gerefi/proteus/export/readme.md

4 layer PCB

135mm x 82.5mm

[changelog.md](../changelog.md)

https://github.com/gerefi/gerefi/wiki/Hardware-Proteus-Fabrication
