gerefi/proteus/readme_pinout.md

# Proteus Pinout & Wiring

### [Please use the official gerefi Proteus docs here.](https://github.com/gerefi/gerefi/wiki/Proteus-Manual)
