gerefi/proteus/export/proteus-case.step

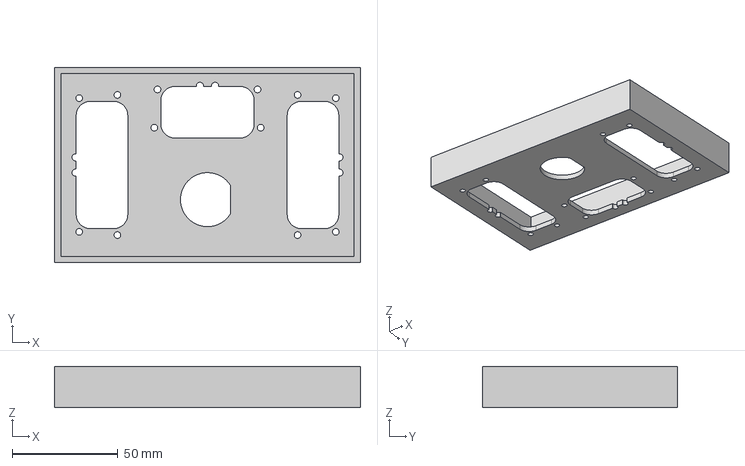
[picture p1: CAD file, 2024-03-12]
export/proteus-case.step
145.0 x 92.5 x 19.6 mm
