gerefi/proteus/(list of files, cad)

Other CAD files:
export/Proteus_case_lid_DC-45.dwg
