gerefi/proteus/Pin FMEA.xlsx

Pin type | Short -12v | Short GND | short <supply | Short 12v | short >supply | Tested?
5V sensor supply | E | C | n/a | C | C | case 1 smoke
12v sensor supply | E | C | B | A | A | case 1 reverse supplies main reg
Analog volt | B | A | A | B | B | yes
Analog temp | B | A | A | B | B | yes
Digital input | A | A | A | A | A | yes
VR input | C | C | C | C | C | yes
CANH/CANL | C | C | C | C | C | yes
Lowside output | E | C | C | C | C | case 1 smoke
Lowside output w/ diode | E | C | C | C | C | case 1 smoke
Ignition output | E | C | C | E | E | case 1 melted series R, case 4/5 overvolt 5v rail or melt R
High side output | C | C | C | C | E | case 5 smoke
Knock input | A | A | A | A | A | by design, no DC path
ETB | E | C | C | C | E | case 1 smoke, case 5 smoke
Ign supply (18) | C | n/a | B | A | A | yes
MR supply (23) | E | n/a | B | A | A | case 1 not allowed by TLE9201 DS
