gerefi/proteus/export/v0.4/proteus_0_4_schematic.pdf

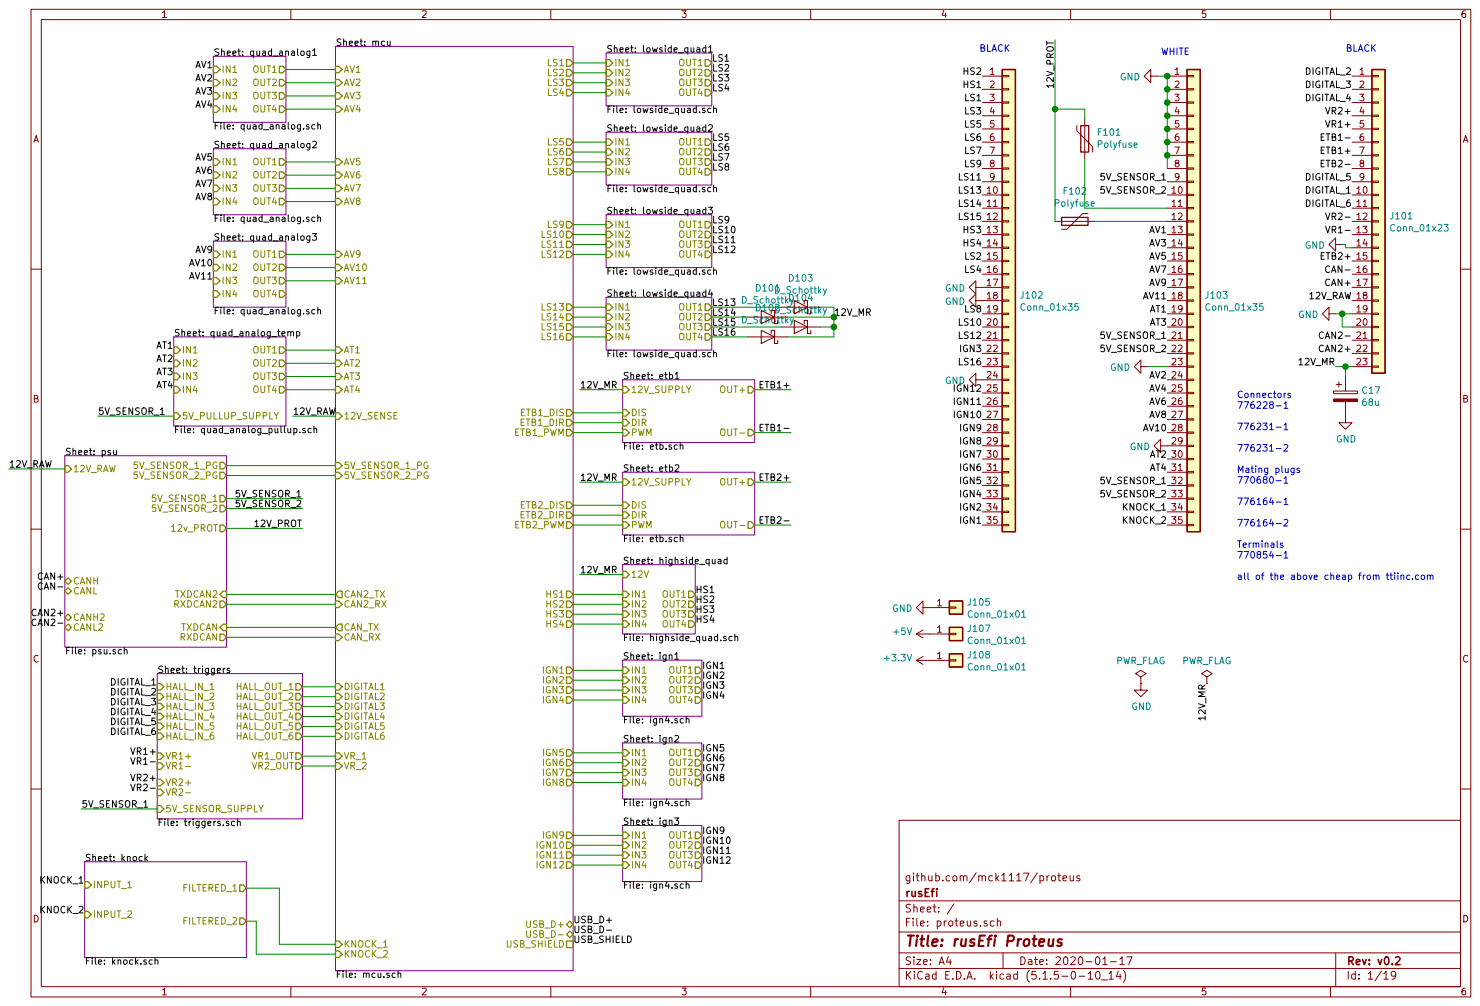
[picture p21: page 1]

Sheet: etb1 File: etb.sch

all of the above cheap from ttiinc.com

File: proteus.sch Sheet: / rusEfi github.com/mck1117/proteus

Id: 1/19 Title: rusEfi Proteus

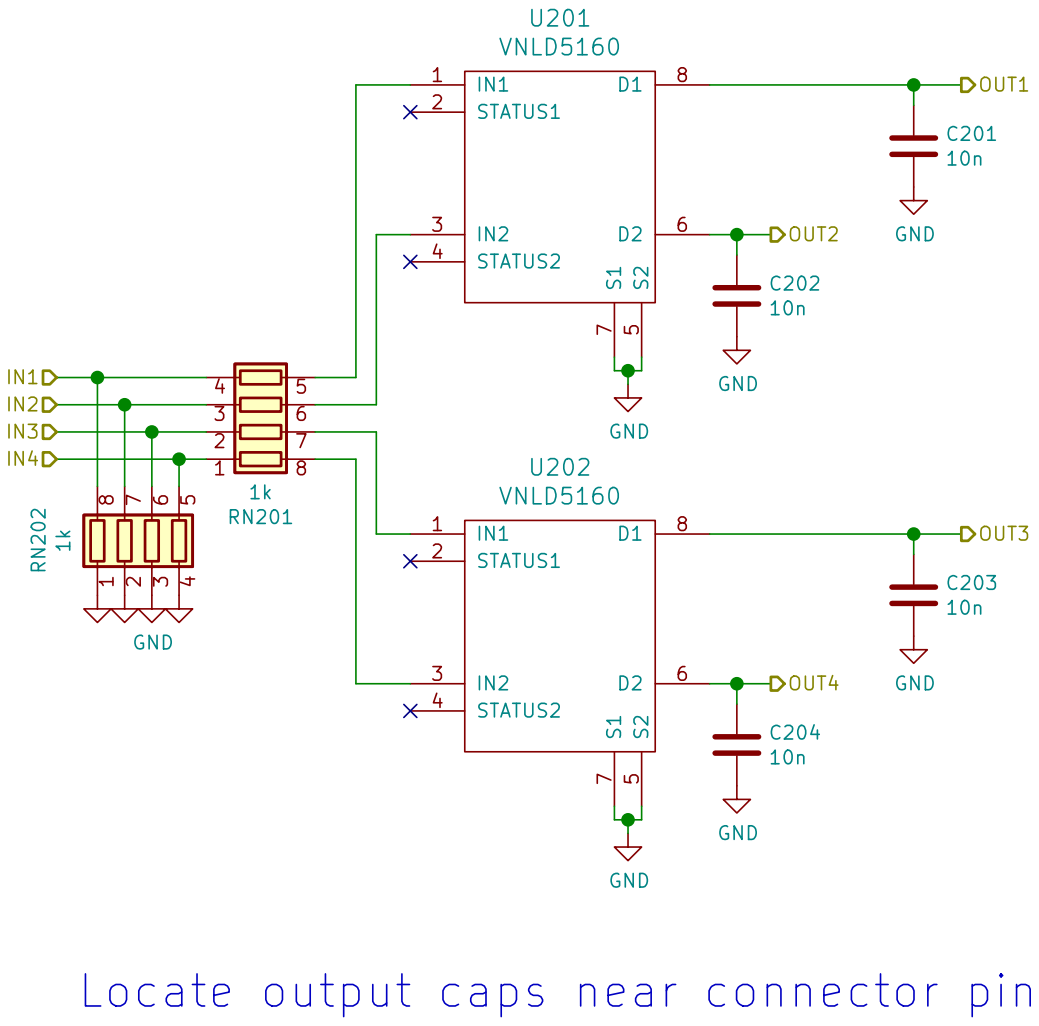
[picture p22: page 2]

7 D1 8 U201 VNLD5160GND GND GND GND GND GND GND

Sheet: /lowside_quad1/ rusEfi github.com/mck1117/proteus

File: lowside_quad.sch
Id: 2/19 Title: rusEfi Proteus

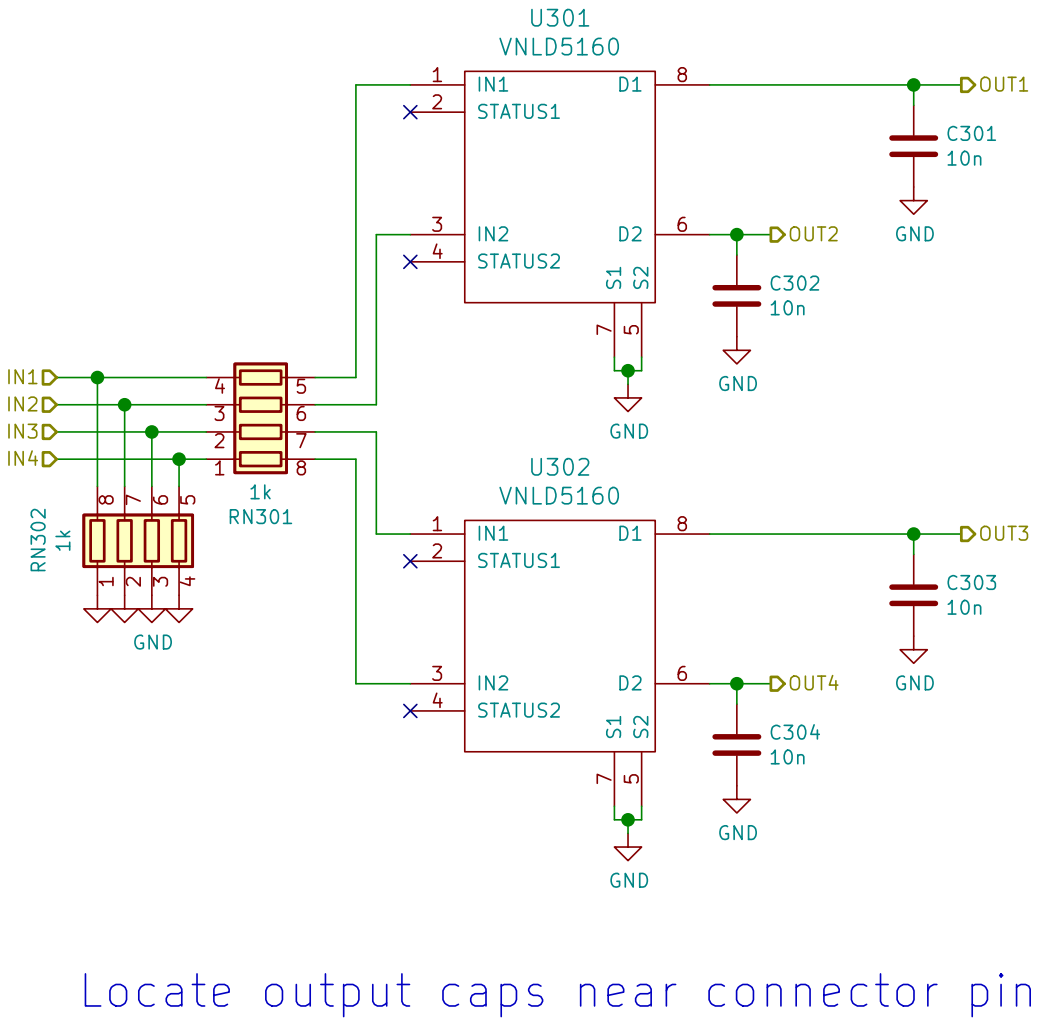
[picture p23: page 3]

7 D1 8 U301 VNLD5160GND GND GND GND GND GND GND

Sheet: /lowside_quad2/ rusEfi github.com/mck1117/proteus

File: lowside_quad.sch
Id: 3/19 Title: rusEfi Proteus

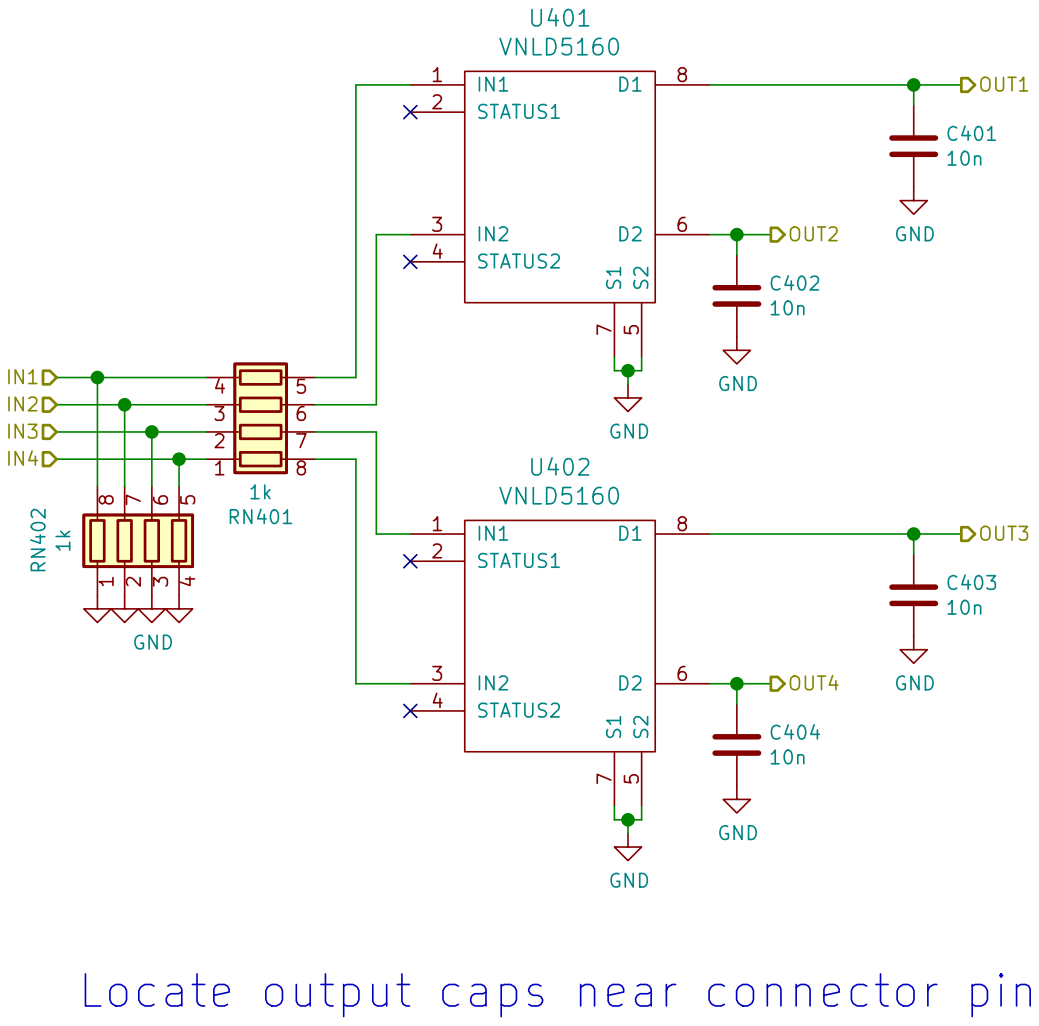
[picture p24: page 4]

7 D1 8 U401 VNLD5160GND GND GND GND GND GND GND

Sheet: /lowside_quad3/ rusEfi github.com/mck1117/proteus

File: lowside_quad.sch
Id: 4/19 Title: rusEfi Proteus

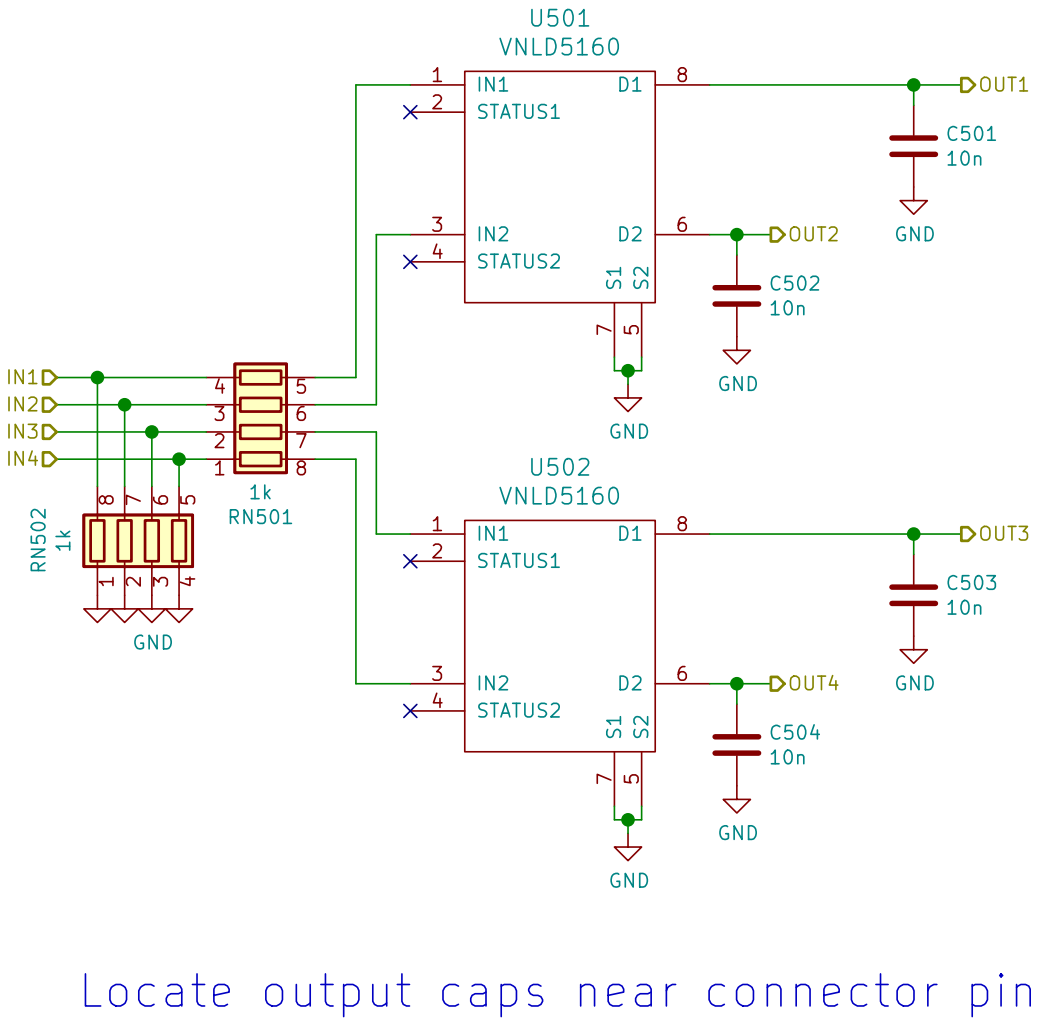
[picture p25: page 5]

7 D1 8 U501 VNLD5160GND GND GND GND GND GND GND

Sheet: /lowside_quad4/ rusEfi github.com/mck1117/proteus

File: lowside_quad.sch
Id: 5/19 Title: rusEfi Proteus

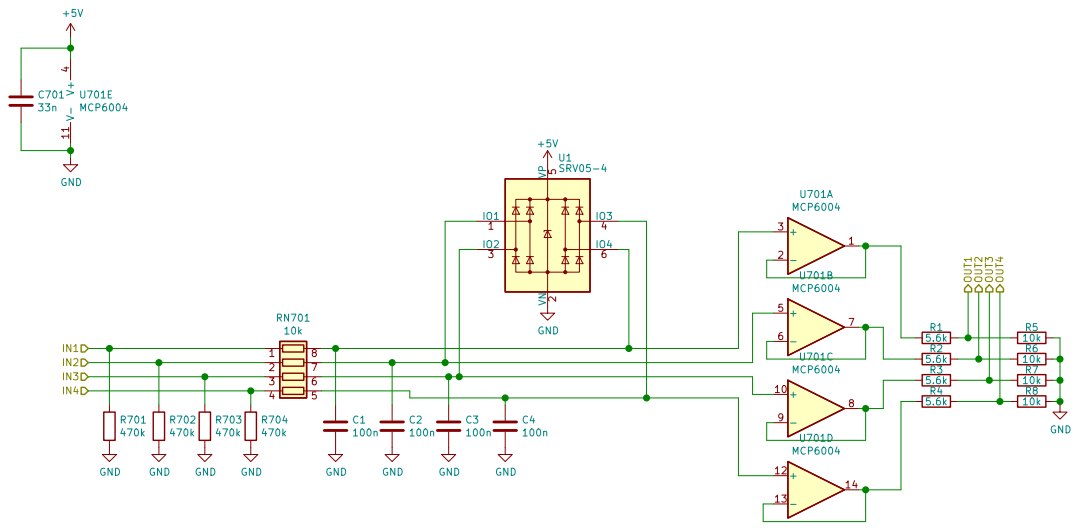
[picture p26: page 6]

Sheet: /quad_analog1/ rusEfi github.com/mck1117/proteus

File: quad_analog.sch
Id: 6/19 Title: rusEfi Proteus

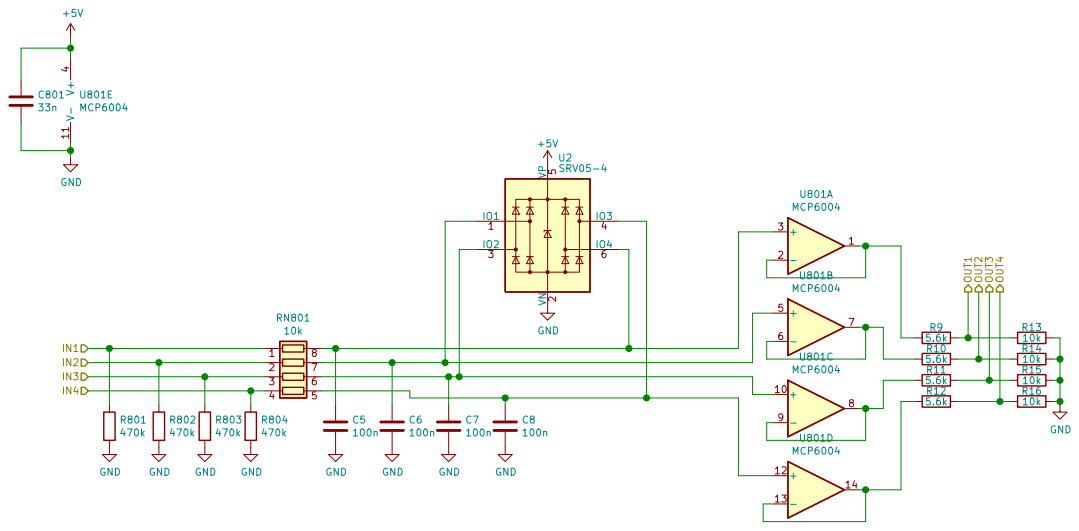
[picture p27: page 7]

Sheet: /quad_analog2/ rusEfi github.com/mck1117/proteus

File: quad_analog.sch
Id: 7/19 Title: rusEfi Proteus

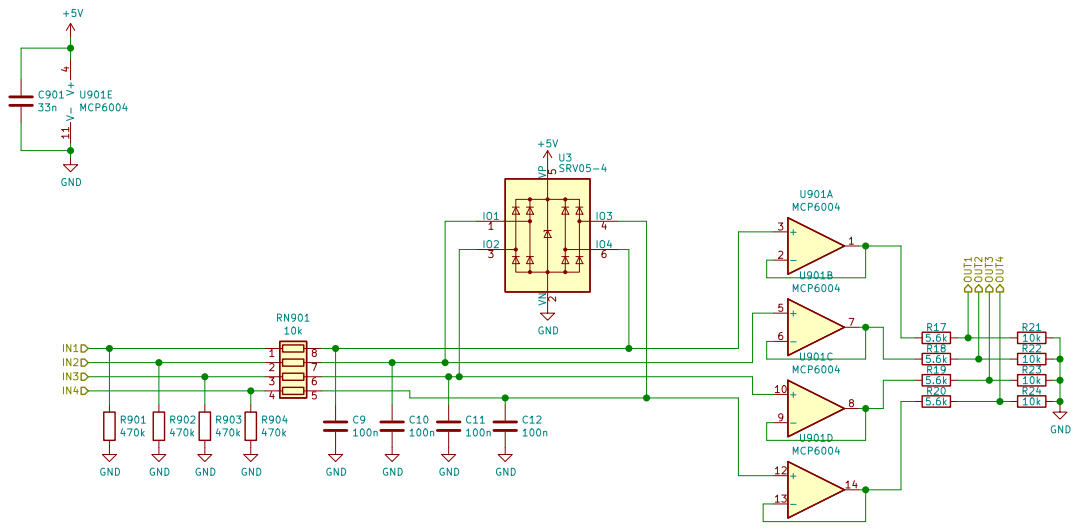
[picture p28: page 8]

Sheet: /quad_analog3/ rusEfi github.com/mck1117/proteus

File: quad_analog.sch
Id: 8/19 Title: rusEfi Proteus

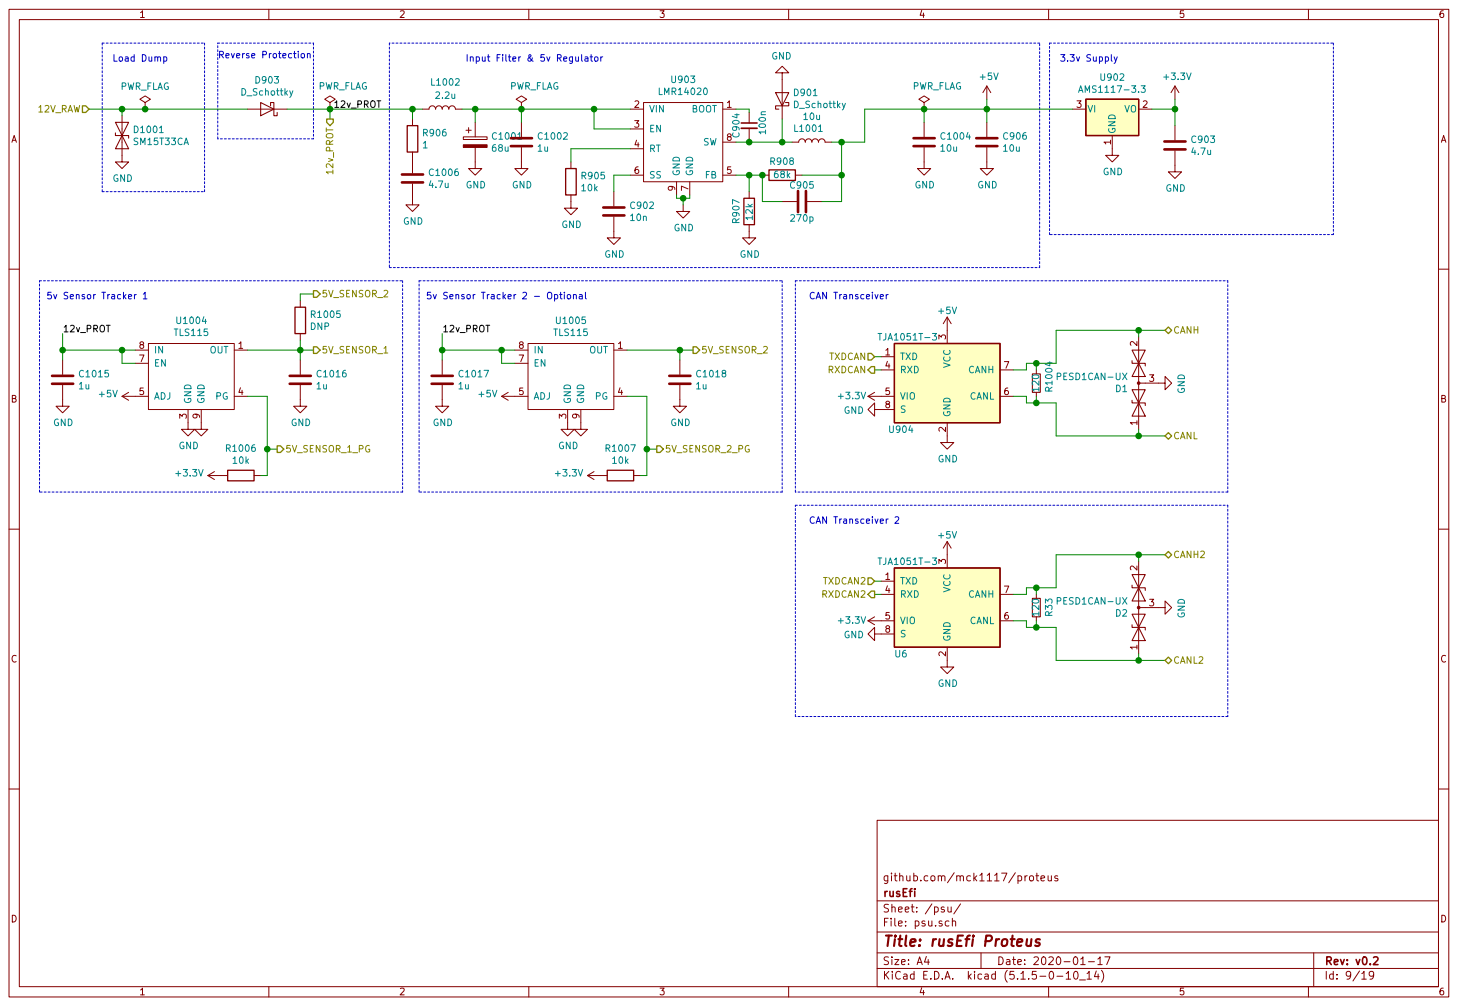
[picture p29: page 9]

1 VO 2 VI 3 U902 AMS1117-3.3 GND GND

3 RXD 4 VIO 5 CANL 6 CANH 7 S

Sheet: /psu/ rusEfi github.com/mck1117/proteus GND

File: psu.sch
Id: 9/19 Title: rusEfi Proteus

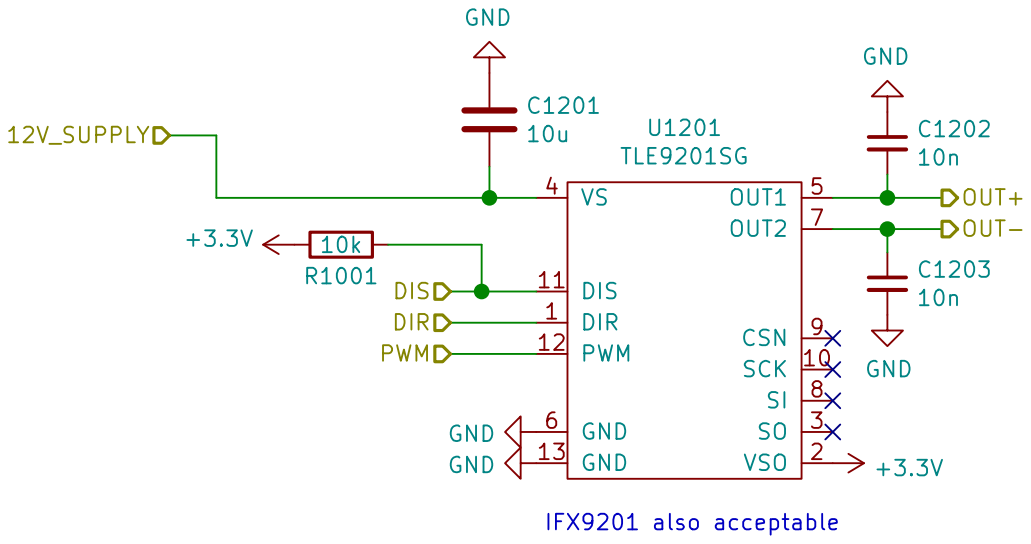
[picture p30: page 10]

File: etb.sch Sheet: /etb1/ rusEfi github.com/mck1117/proteus

Id: 10/19 Title: rusEfi Proteus

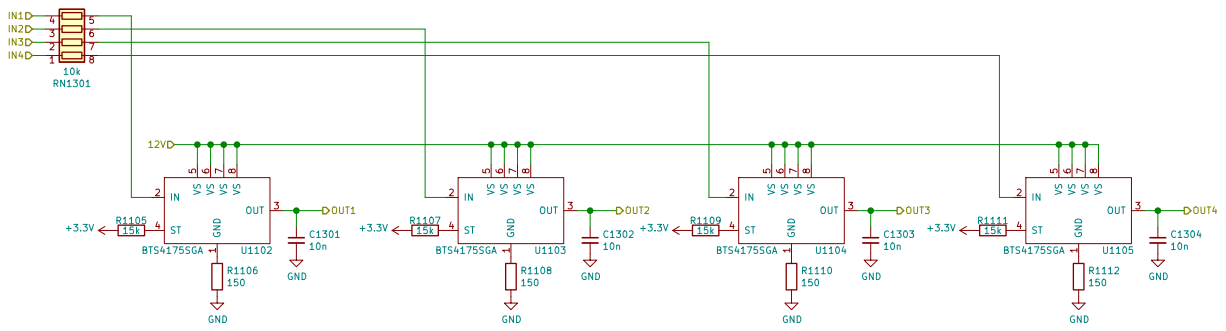
[picture p31: page 11]

Sheet: /highside_quad/ rusEfi github.com/mck1117/proteus

File: highside_quad.sch
Id: 11/19 Title: rusEfi Proteus

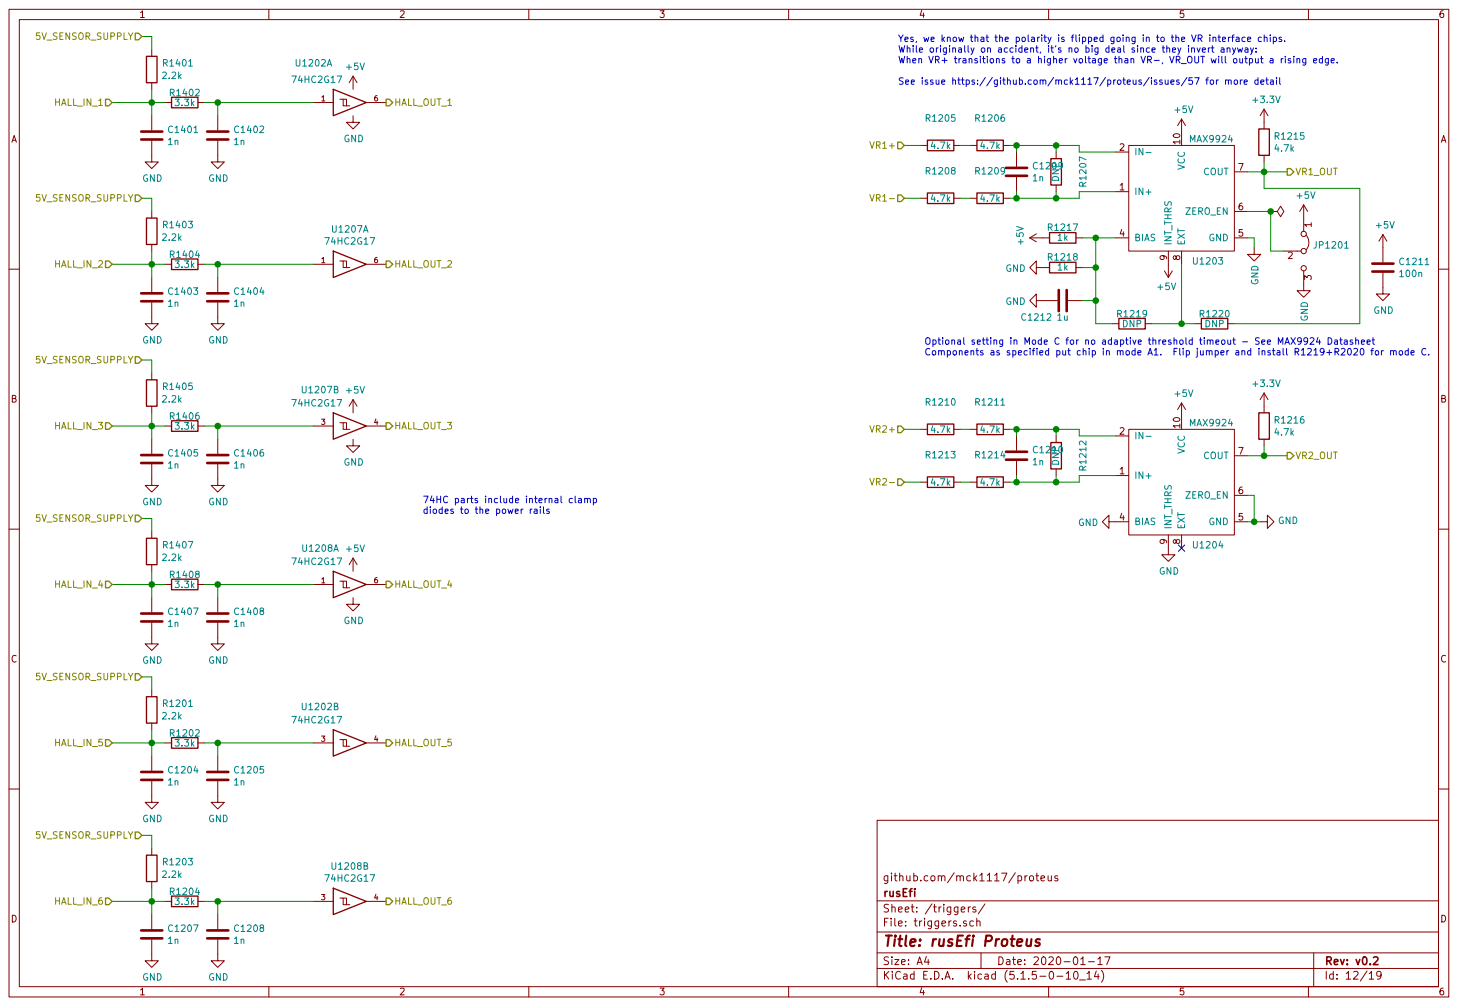
[picture p32: page 12]

Yes, we know that the polarity is flipped going in to the VR interface chips.
While originally on accident, its no big deal since they invert anyway:
When VR+ transitions to a higher voltage than VR-, VR_OUT will output a rising edge.

See issue https://github.com/mck1117/proteus/issues/57 for more detail

Optional setting in Mode C for no adaptive threshold timeout - See MAX9924 Datasheet
Components as specified put chip in mode A1. Flip jumper and install R1219+R2020 for mode C.

74HC parts include internal clamp
diodes to the power rails

Sheet: /triggers/ rusEfi github.com/mck1117/proteus

File: triggers.sch
Id: 12/19 Title: rusEfi Proteus

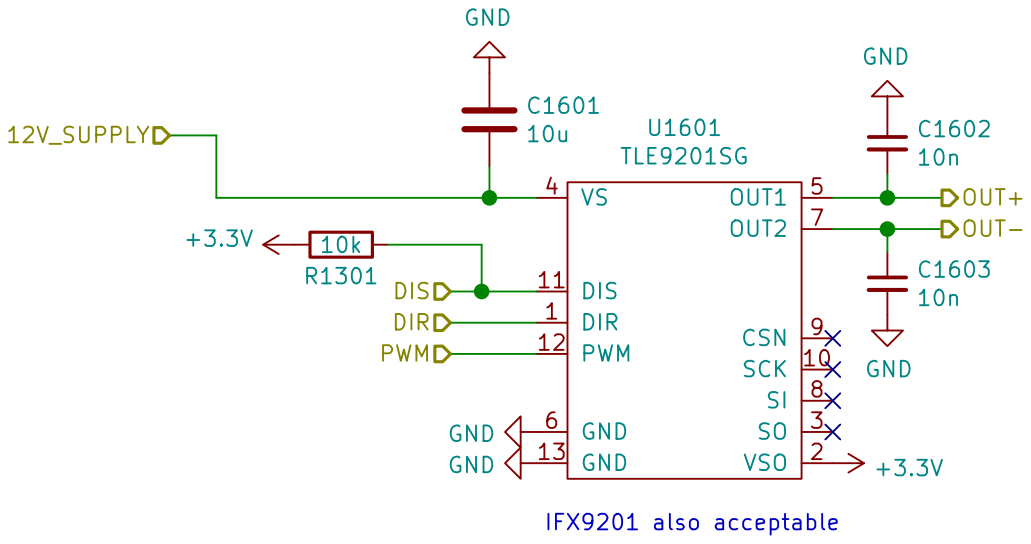
[picture p33: page 13]

File: etb.sch Sheet: /etb2/ rusEfi github.com/mck1117/proteus

Id: 13/19 Title: rusEfi Proteus

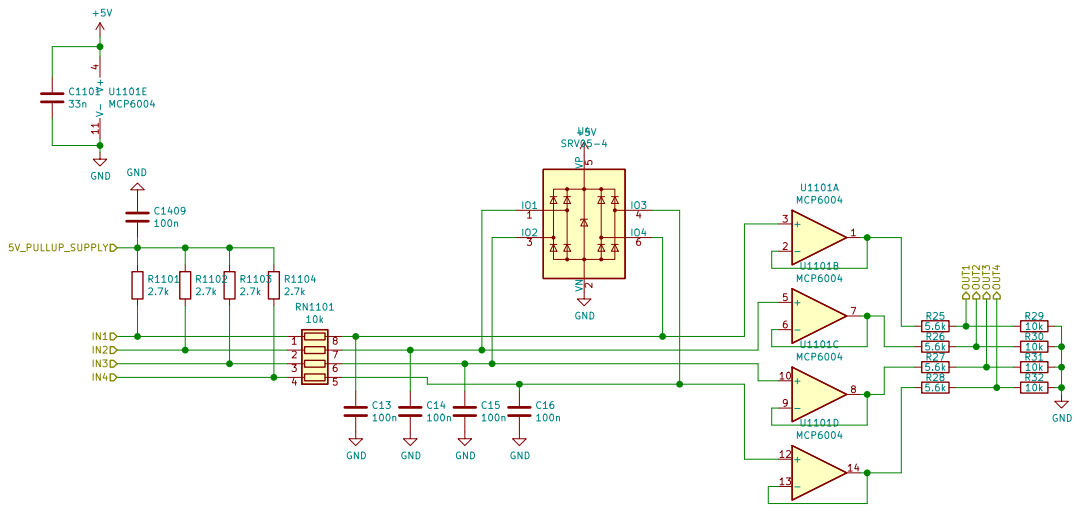
[picture p34: page 14]

Sheet: /quad_analog_temp/ rusEfi github.com/mck1117/proteus

File: quad_analog_pullup.sch
Id: 14/19 Title: rusEfi Proteus

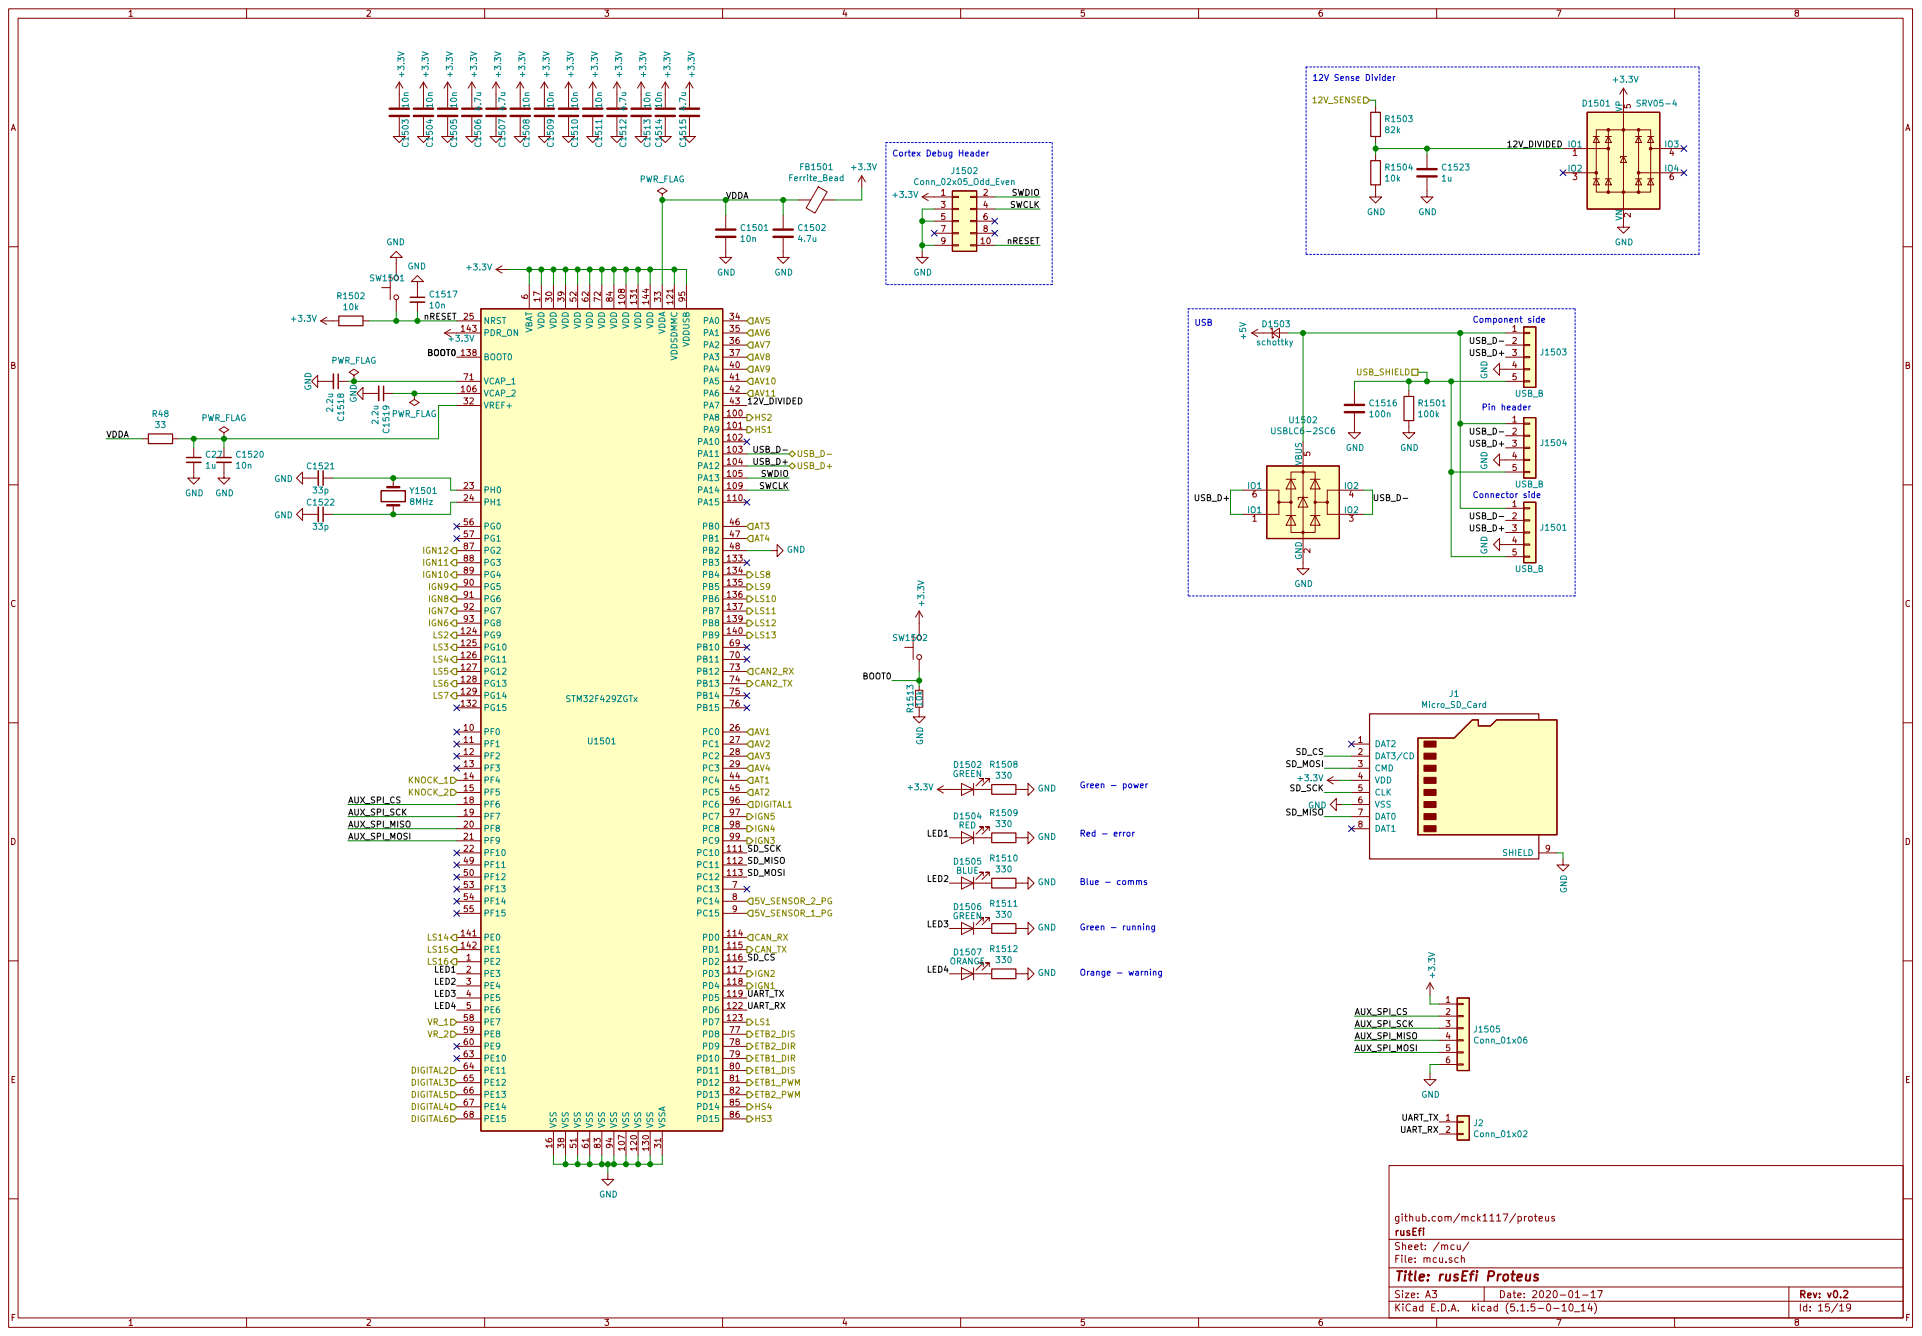
[picture p35: page 15]

Green - running Blue - comms Green - power Red - error

File: mcu.sch Sheet: /mcu/ rusEfi github.com/mck1117/proteus 12
UART_RX

Id: 15/19 Title: rusEfi Proteus

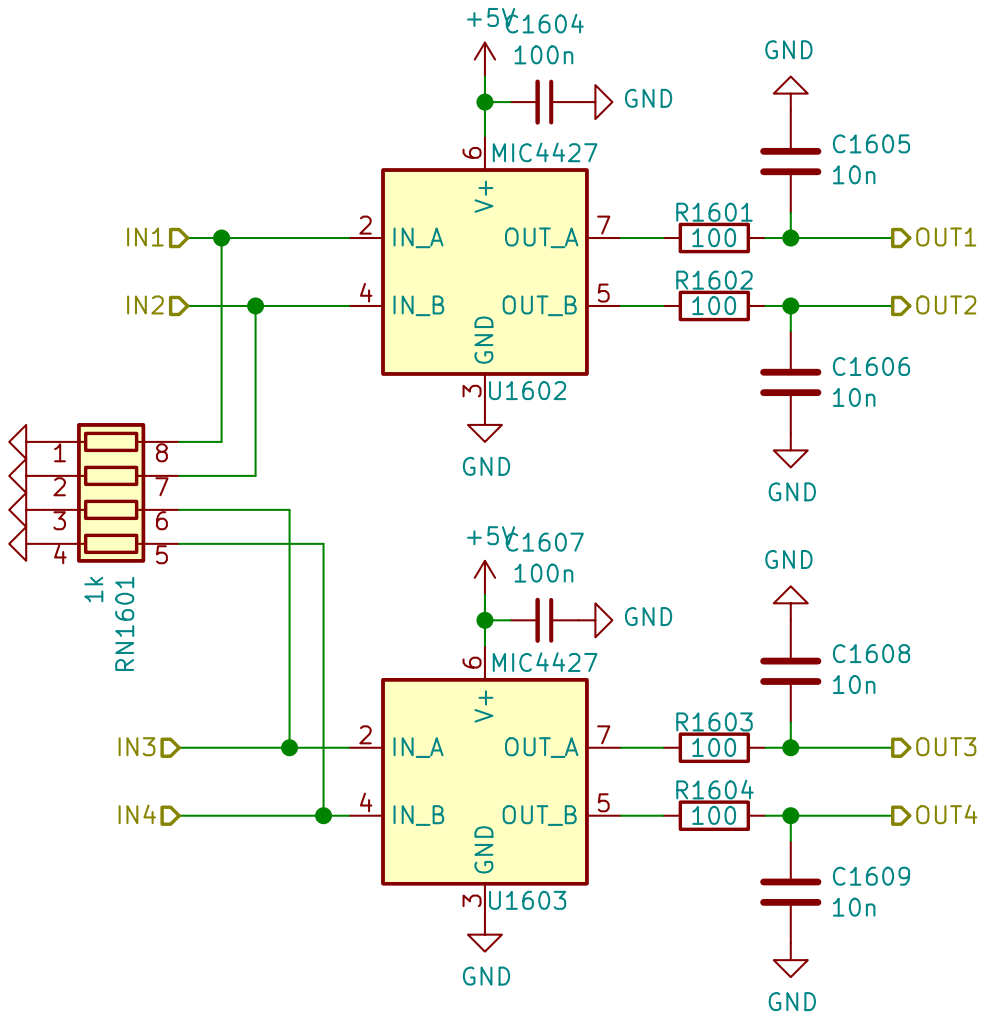
[picture p36: page 16]

Sheet: /ign1/ rusEfi github.com/mck1117/proteus

File: ign4.sch
Id: 16/19 Title: rusEfi Proteus

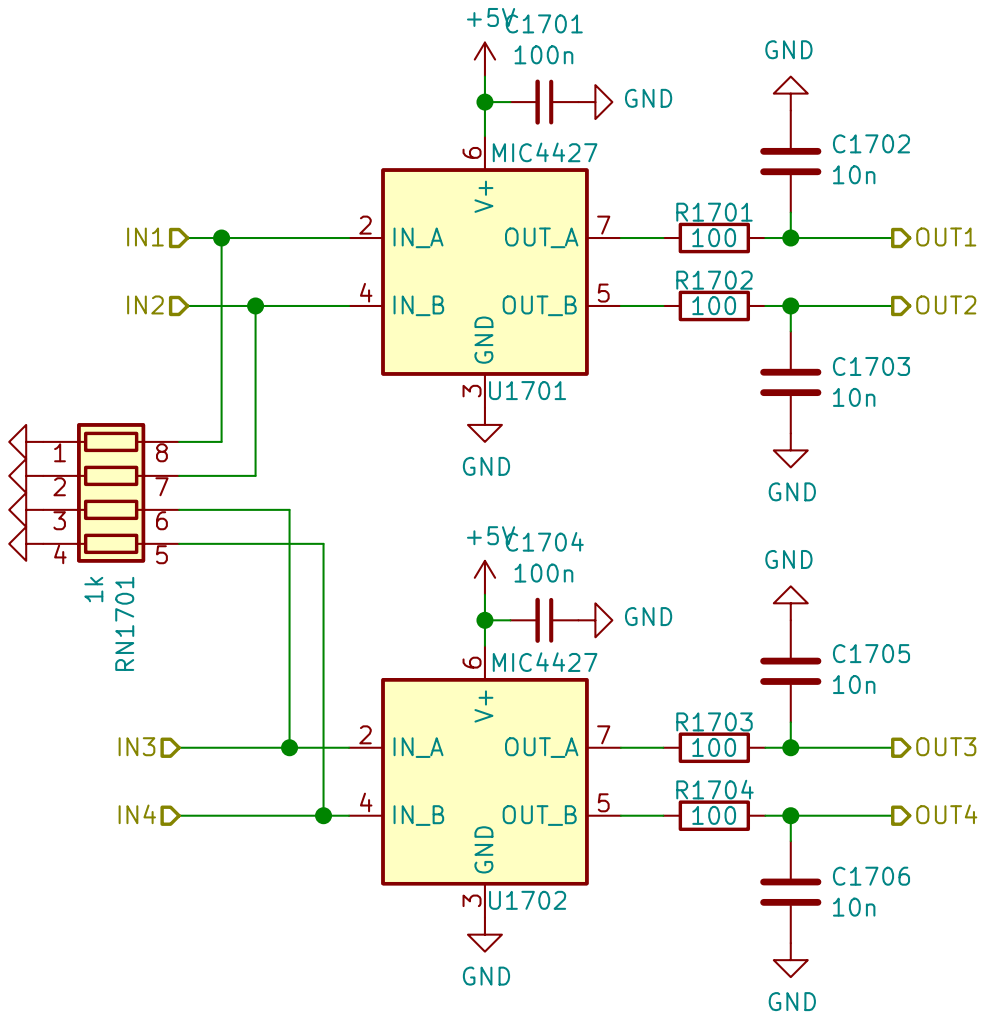
[picture p37: page 17]

Sheet: /ign2/ rusEfi github.com/mck1117/proteus

File: ign4.sch
Id: 17/19 Title: rusEfi Proteus

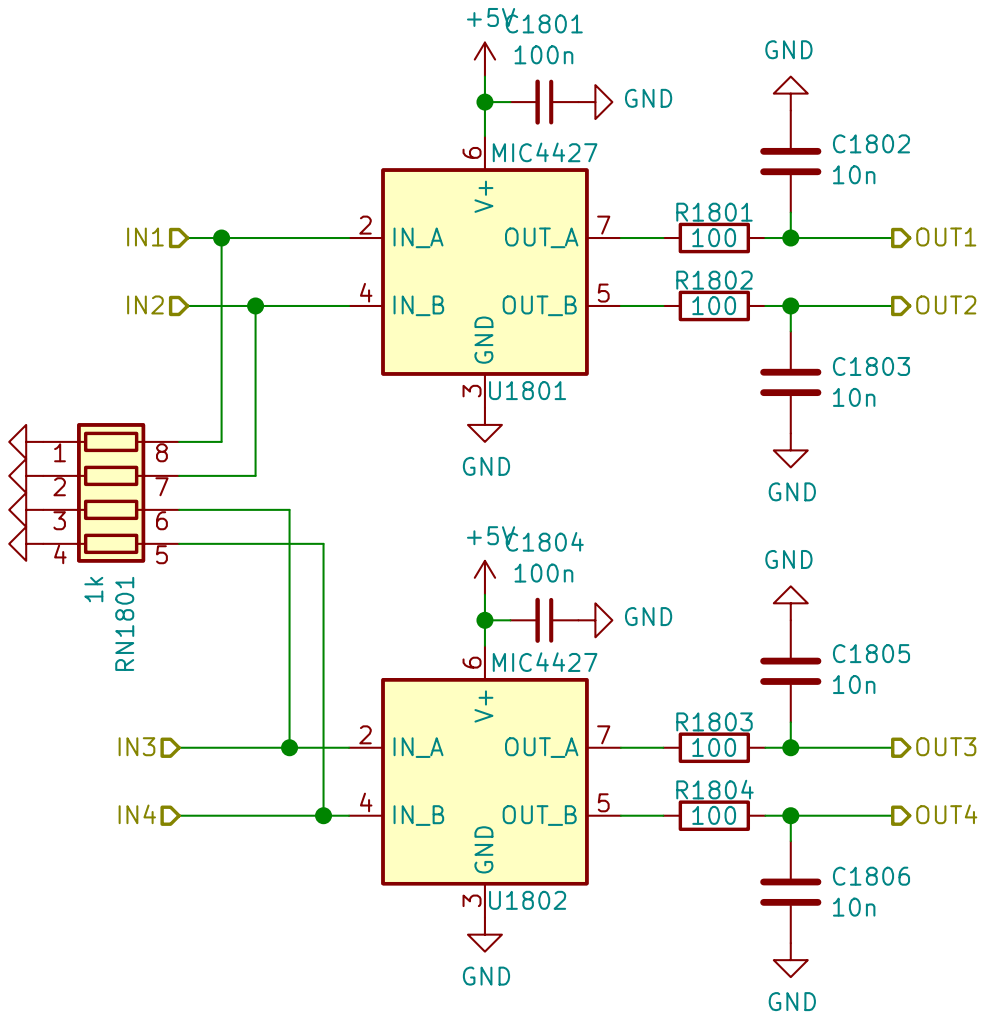
[picture p38: page 18]

Sheet: /ign3/ rusEfi github.com/mck1117/proteus

File: ign4.sch
Id: 18/19 Title: rusEfi Proteus

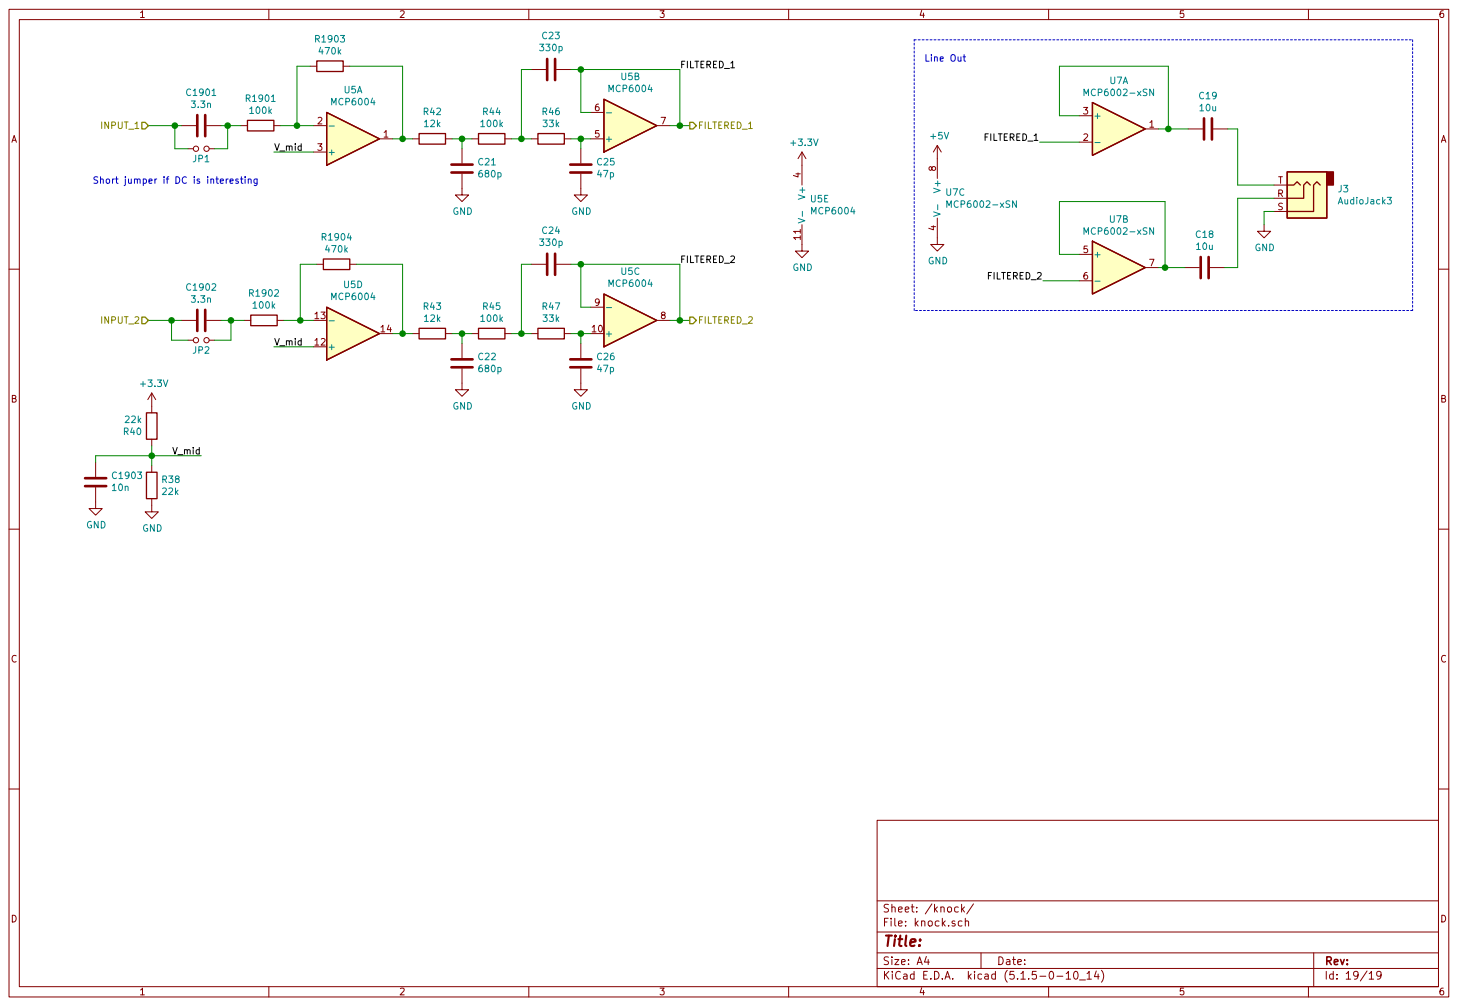
[picture p39: page 19]

Id: 19/19 Title: File: knock.sch Sheet: /knock/
