gerefi/proteus/etb-9201.sch

## KiCad design etb-9201.sch (2024-03-12)

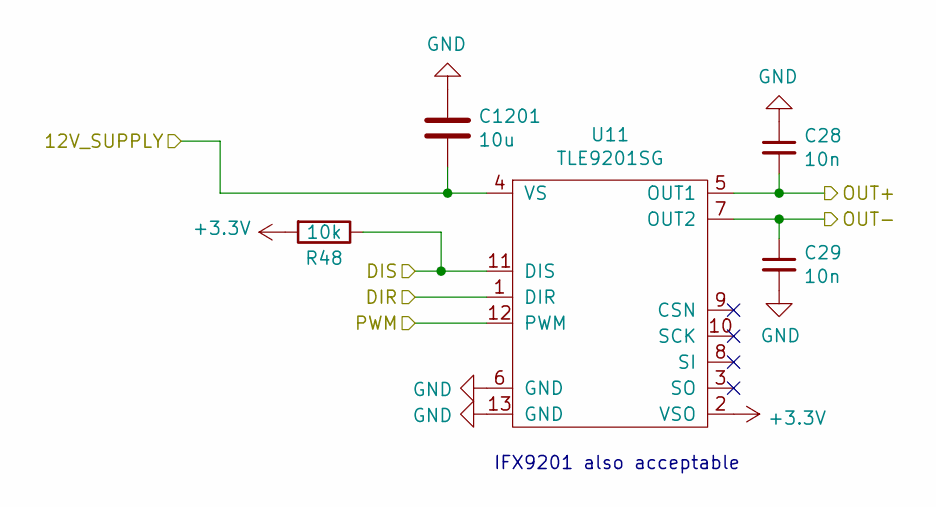
[picture p46: schematic etb-9201.sch]

Parts:
C1201: 10u; C_1206_3216Metric; LCSC C13585
C1202, C1203: 10n; C_0603_1608Metric; LCSC C57112
R1001: 10k; R_0402_1005Metric; LCSC C25744
U1201: TLE9201SG; Infineon_PG-DSO-12-9; LCSC C112633

Connections:
12V_SUPPLY: C1201.2, U1201.4 (VS)
+3.3V: R1001.2, U1201.2 (VSO)
DIR: U1201.1 (DIR)
DIS: R1001.1, U1201.11 (DIS)
GND: C1201.1, C1202.1, C1203.2, U1201.6 (GND), U1201.13 (GND)
OUT+: C1202.2, U1201.5 (OUT1)
OUT-: C1203.1, U1201.7 (OUT2)
PWM: U1201.12 (PWM)

Notes on the sheet:
IFX9201 also acceptable
