gerefi/proteus/etb.sch

## KiCad design etb.sch (2024-03-12)

Schematic: etb.sch

Parts:
C27, C1201: 10u; C_1206_3216Metric; LCSC C13585
C28, C29, C1202, C1203: 10n; C_0603_1608Metric; LCSC C57112
R48, R1001: 10k; R_0402_1005Metric; LCSC C25744
U10: TLE9202; PG-DSO-36-72; LCSC N/A
