gerefi/proteus/highside_quad.sch

## KiCad design highside_quad.sch (2024-03-12)

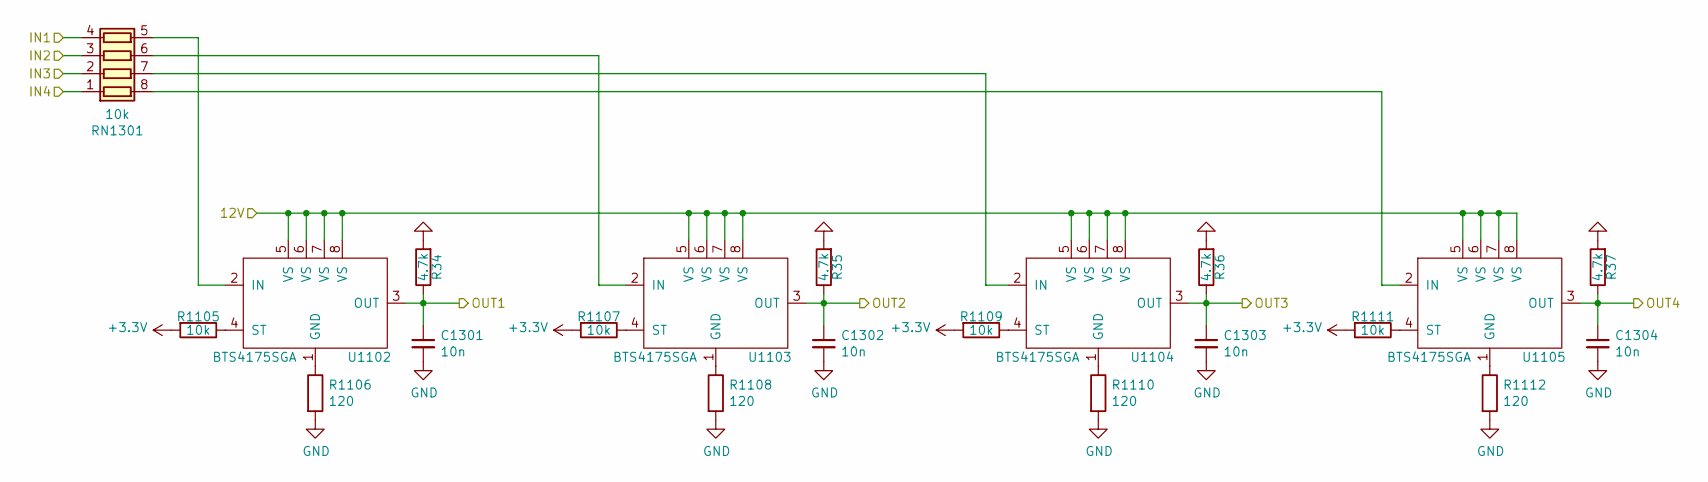
[picture p47: schematic highside_quad.sch]

Parts:
C1301, C1302, C1303, C1304: 10n; C_0603_1608Metric; LCSC C57112
R34, R35, R36, R37: 4.7k; R_0805_2012Metric; LCSC C17673
R1105, R1107, R1109, R1111: 10k; R_0402_1005Metric; LCSC C25744
R1106, R1108, R1110, R1112: 120; R_0603_1608Metric; LCSC C22787
RN1301: 10k; R_Array_Convex_4x0603; LCSC C29718
U1102, U1103, U1104, U1105: BTS4175SGA; SOIC-8_3.9x4.9mm_P1.27mm; LCSC C152451

Connections:
12V: U1102.5 (VS), U1102.6 (VS), U1102.7 (VS), U1102.8 (VS), U1103.5 (VS), U1103.6 (VS), U1103.7 (VS), U1103.8 (VS), U1104.5 (VS), U1104.6 (VS), U1104.7 (VS), U1104.8 (VS), U1105.5 (VS), U1105.6 (VS), U1105.7 (VS), U1105.8 (VS)
+3.3V: R1105.2, R1107.2, R1109.2, R1111.2
GND: C1301.2, C1302.2, C1303.2, C1304.2, R34.2, R35.2, R36.2, R37.2, R1106.2, R1108.2, R1110.2, R1112.2
IN1: RN1301.4 (R4.1)
IN2: RN1301.3 (R3.1)
IN3: RN1301.2 (R2.1)
IN4: RN1301.1 (R1.1)
unnamed: R1105.1, U1102.4 (ST)
unnamed: R1106.1, U1102.1 (GND)
unnamed: R1107.1, U1103.4 (ST)
unnamed: R1108.1, U1103.1 (GND)
unnamed: R1109.1, U1104.4 (ST)
unnamed: R1110.1, U1104.1 (GND)
unnamed: R1111.1, U1105.4 (ST)
unnamed: R1112.1, U1105.1 (GND)
unnamed: RN1301.5 (R4.2), U1102.2 (IN)
unnamed: RN1301.6 (R3.2), U1103.2 (IN)
unnamed: RN1301.7 (R2.2), U1104.2 (IN)
unnamed: RN1301.8 (R1.2), U1105.2 (IN)
OUT1: C1301.1, R34.1, U1102.3 (OUT)
OUT2: C1302.1, R35.1, U1103.3 (OUT)
OUT3: C1303.1, R36.1, U1104.3 (OUT)
OUT4: C1304.1, R37.1, U1105.3 (OUT)
