gerefi/proteus/ign4.sch

## KiCad design ign4.sch (2024-03-12)

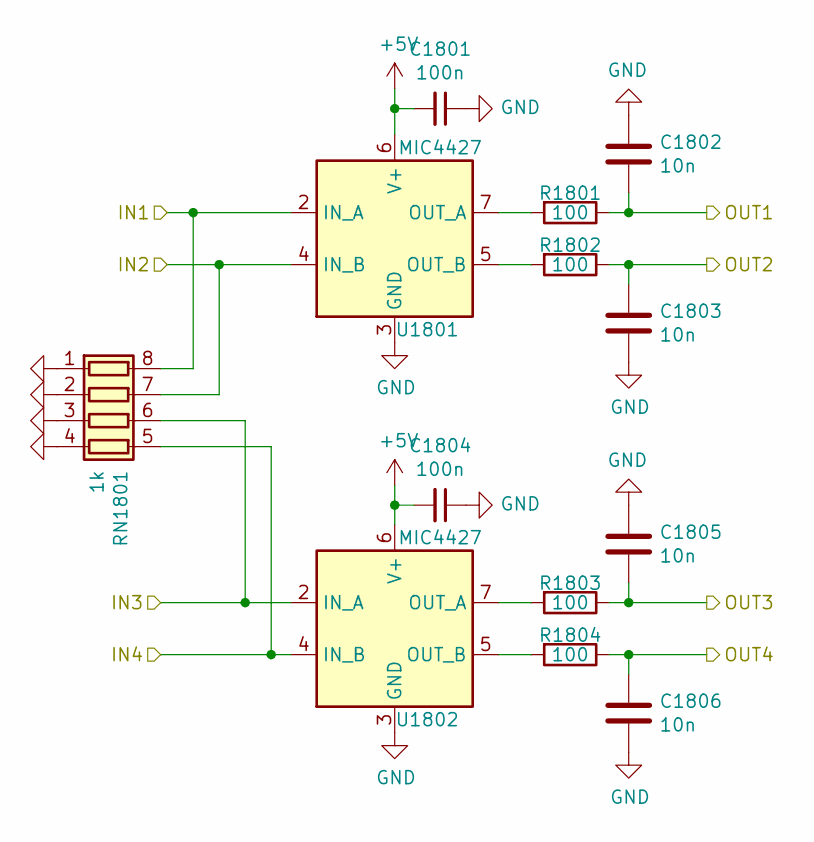
[picture p48: schematic ign4.sch]

Parts:
C1604, C1607: 100n; C_0603_1608Metric; LCSC C14663
C1605, C1606, C1608, C1609: 10n; C_0603_1608Metric; LCSC C57112
R1601, R1602, R1603, R1604: 100; R_0805_2012Metric; LCSC C17408
RN1601: 1k; R_Array_Convex_4x0603; LCSC C20197
U1602, U1603: MIC4427; SOIC-8_3.9x4.9mm_P1.27mm; LCSC C20551

Connections:
+5V: C1604.2, C1607.2, U1602.6 (V+), U1603.6 (V+)
GND: C1604.1, C1605.2, C1606.2, C1607.1, C1608.2, C1609.2, RN1601.1 (R1.1), RN1601.2 (R2.1), RN1601.3 (R3.1), RN1601.4 (R4.1), U1602.3 (GND), U1603.3 (GND)
IN1: RN1601.8 (R1.2), U1602.2 (IN_A)
IN2: RN1601.7 (R2.2), U1602.4 (IN_B)
IN3: RN1601.6 (R3.2), U1603.2 (IN_A)
IN4: RN1601.5 (R4.2), U1603.4 (IN_B)
unnamed: R1601.2, U1602.7 (OUT_A)
unnamed: R1602.2, U1602.5 (OUT_B)
unnamed: R1603.2, U1603.7 (OUT_A)
unnamed: R1604.2, U1603.5 (OUT_B)
OUT1: C1605.1, R1601.1
OUT2: C1606.1, R1602.1
OUT3: C1608.1, R1603.1
OUT4: C1609.1, R1604.1
