gerefi/proteus/knock.sch

## KiCad design knock.sch (2024-03-12)

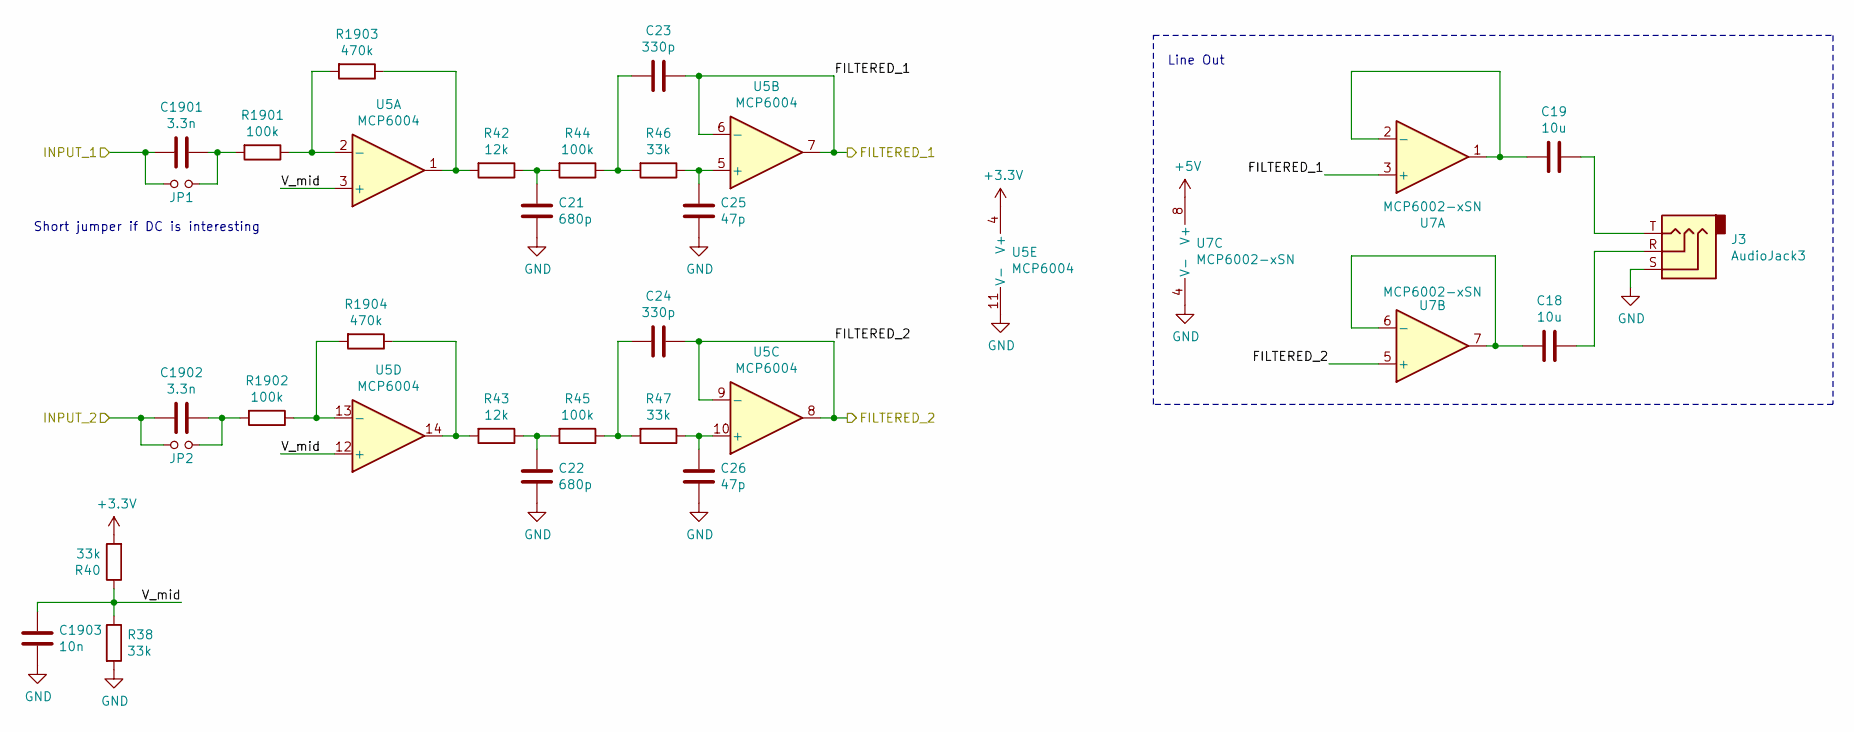
[picture p49: schematic knock.sch]

Parts:
C18, C19: 10u; C_1206_3216Metric; LCSC C13585
C21, C22: 680p; C_0603_1608Metric; LCSC C1630
C23, C24: 330p; C_0402_1005Metric; LCSC C13533
C25, C26: 47p; C_0402_1005Metric; LCSC C1567
C1901, C1902: 3.3n; C_0805_2012Metric; LCSC C53175
C1903: 10n; C_0603_1608Metric; LCSC C57112
J3: AudioJack3; Jack_3.5mm_CUI_SJ1-3533NG_Horizontal; LCSC N/A
JP1, JP2: Jumper_NO_Small; SolderJumper-2_P1.3mm_Open_TrianglePad1.0x1.5mm; LCSC N/A
R38, R40, R46, R47: 33k; R_0402_1005Metric; LCSC C25779
R42, R43: 12k; R_0402_1005Metric; LCSC C25752
R44, R45, R1901, R1902: 100k; R_0402_1005Metric; LCSC C25741
R1903, R1904: 470k; R_0402_1005Metric; LCSC C25790
U5: MCP6004; TSSOP-14_4.4x5mm_P0.65mm; LCSC C50282
U7: MCP6002-xSN; SOIC-8_3.9x4.9mm_P1.27mm; LCSC C7377

Connections:
+3.3V: R40.2, U5.4 (V+)
+5V: U7.8 (V+)
FILTERED_1: C23.2, U5.6 (-), U5.7, U7.3 (+)
FILTERED_2: C24.2, U5.8, U5.9 (-), U7.5 (+)
GND: C21.1, C22.1, C25.1, C26.1, C1903.1, J3.S, R38.2, U5.11 (V-), U7.4 (V-)
INPUT_1: C1901.2, JP1.1
INPUT_2: C1902.2, JP2.1
unnamed: C18.1, J3.R
unnamed: C18.2, U7.6 (-), U7.7
unnamed: C19.1, J3.T
unnamed: C19.2, U7.1, U7.2 (-)
unnamed: C21.2, R42.1, R44.2
unnamed: C22.2, R43.1, R45.2
unnamed: C23.1, R44.1, R46.2
unnamed: C24.1, R45.1, R47.2
unnamed: C25.2, R46.1, U5.5 (+)
unnamed: C26.2, R47.1, U5.10 (+)
unnamed: C1901.1, JP1.2, R1901.2
unnamed: C1902.1, JP2.2, R1902.2
unnamed: R1901.1, R1903.2, U5.2 (-)
unnamed: R1902.1, R1904.2, U5.13 (-)
unnamed: R42.2, R1903.1, U5.1
unnamed: R43.2, R1904.1, U5.14
V_mid: C1903.2, R38.1, R40.1, U5.3 (+), U5.12 (+)

Notes on the sheet:
Short jumper if DC is interesting
Line Out
