gerefi/proteus/lowside_quad.sch

## KiCad design lowside_quad.sch (2024-03-12)

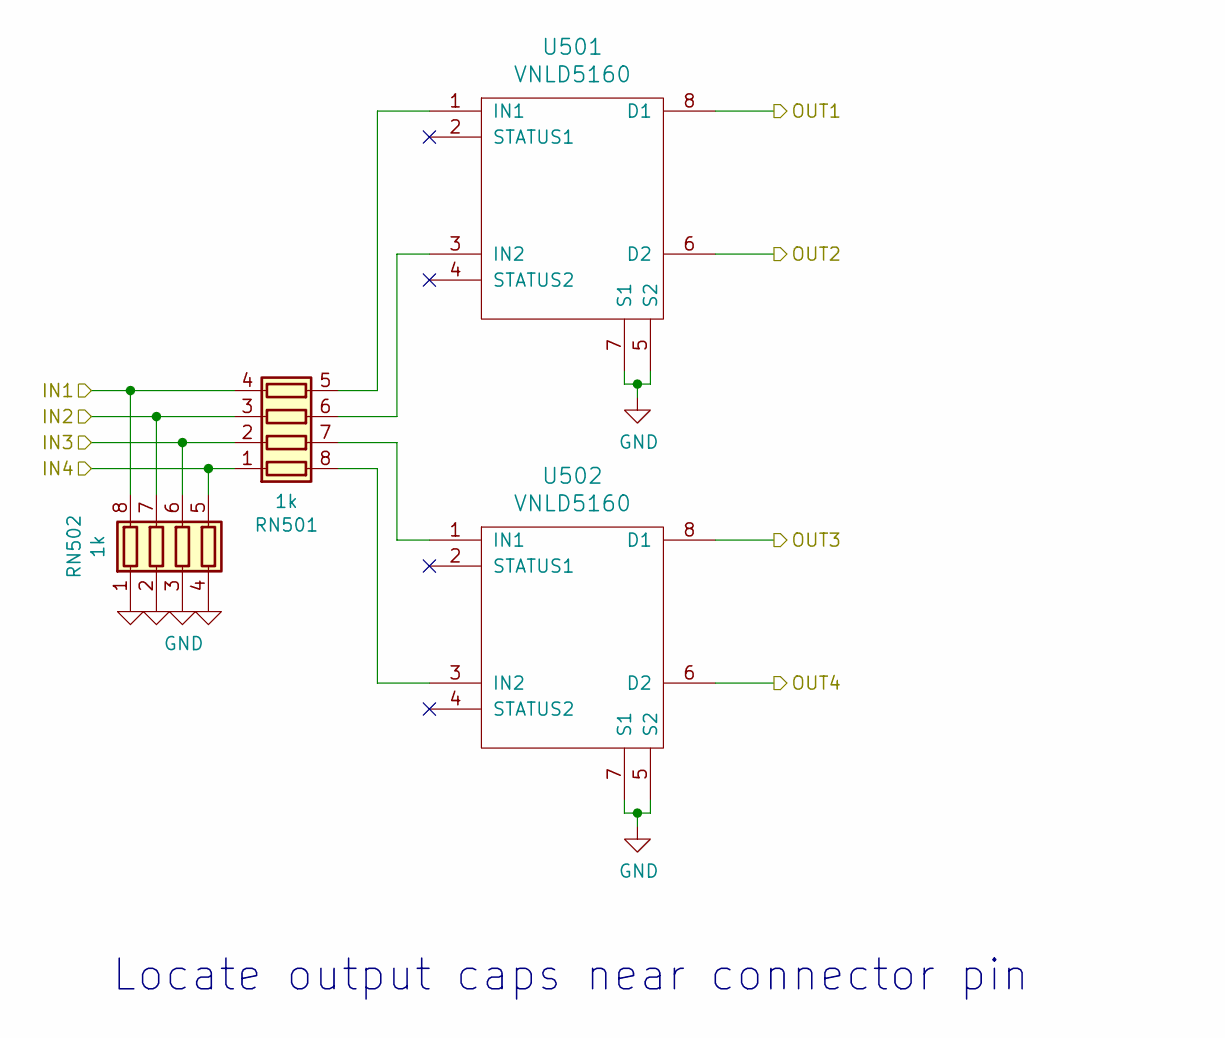
[picture p50: schematic lowside_quad.sch]

Parts:
RN201, RN202: 1k; R_Array_Convex_4x0603; LCSC C20197
U201, U202: VNLD5160; SOIC-8_3.9x4.9mm_P1.27mm; LCSC N/A

Connections:
GND: RN202.1 (R1.1), RN202.2 (R2.1), RN202.3 (R3.1), RN202.4 (R4.1), U201.5 (S2), U201.7 (S1), U202.5 (S2), U202.7 (S1)
IN1: RN201.4 (R4.1), RN202.8 (R1.2)
IN2: RN201.3 (R3.1), RN202.7 (R2.2)
IN3: RN201.2 (R2.1), RN202.6 (R3.2)
IN4: RN201.1 (R1.1), RN202.5 (R4.2)
unnamed: RN201.5 (R4.2), U201.1 (IN1)
unnamed: RN201.6 (R3.2), U201.3 (IN2)
unnamed: RN201.7 (R2.2), U202.1 (IN1)
unnamed: RN201.8 (R1.2), U202.3 (IN2)
OUT1: U201.8 (D1)
OUT2: U201.6 (D2)
OUT3: U202.8 (D1)
OUT4: U202.6 (D2)

Notes on the sheet:
Locate output caps near connector pin
