gerefi/proteus/proteus.sch

## KiCad design proteus.sch (2024-03-12)

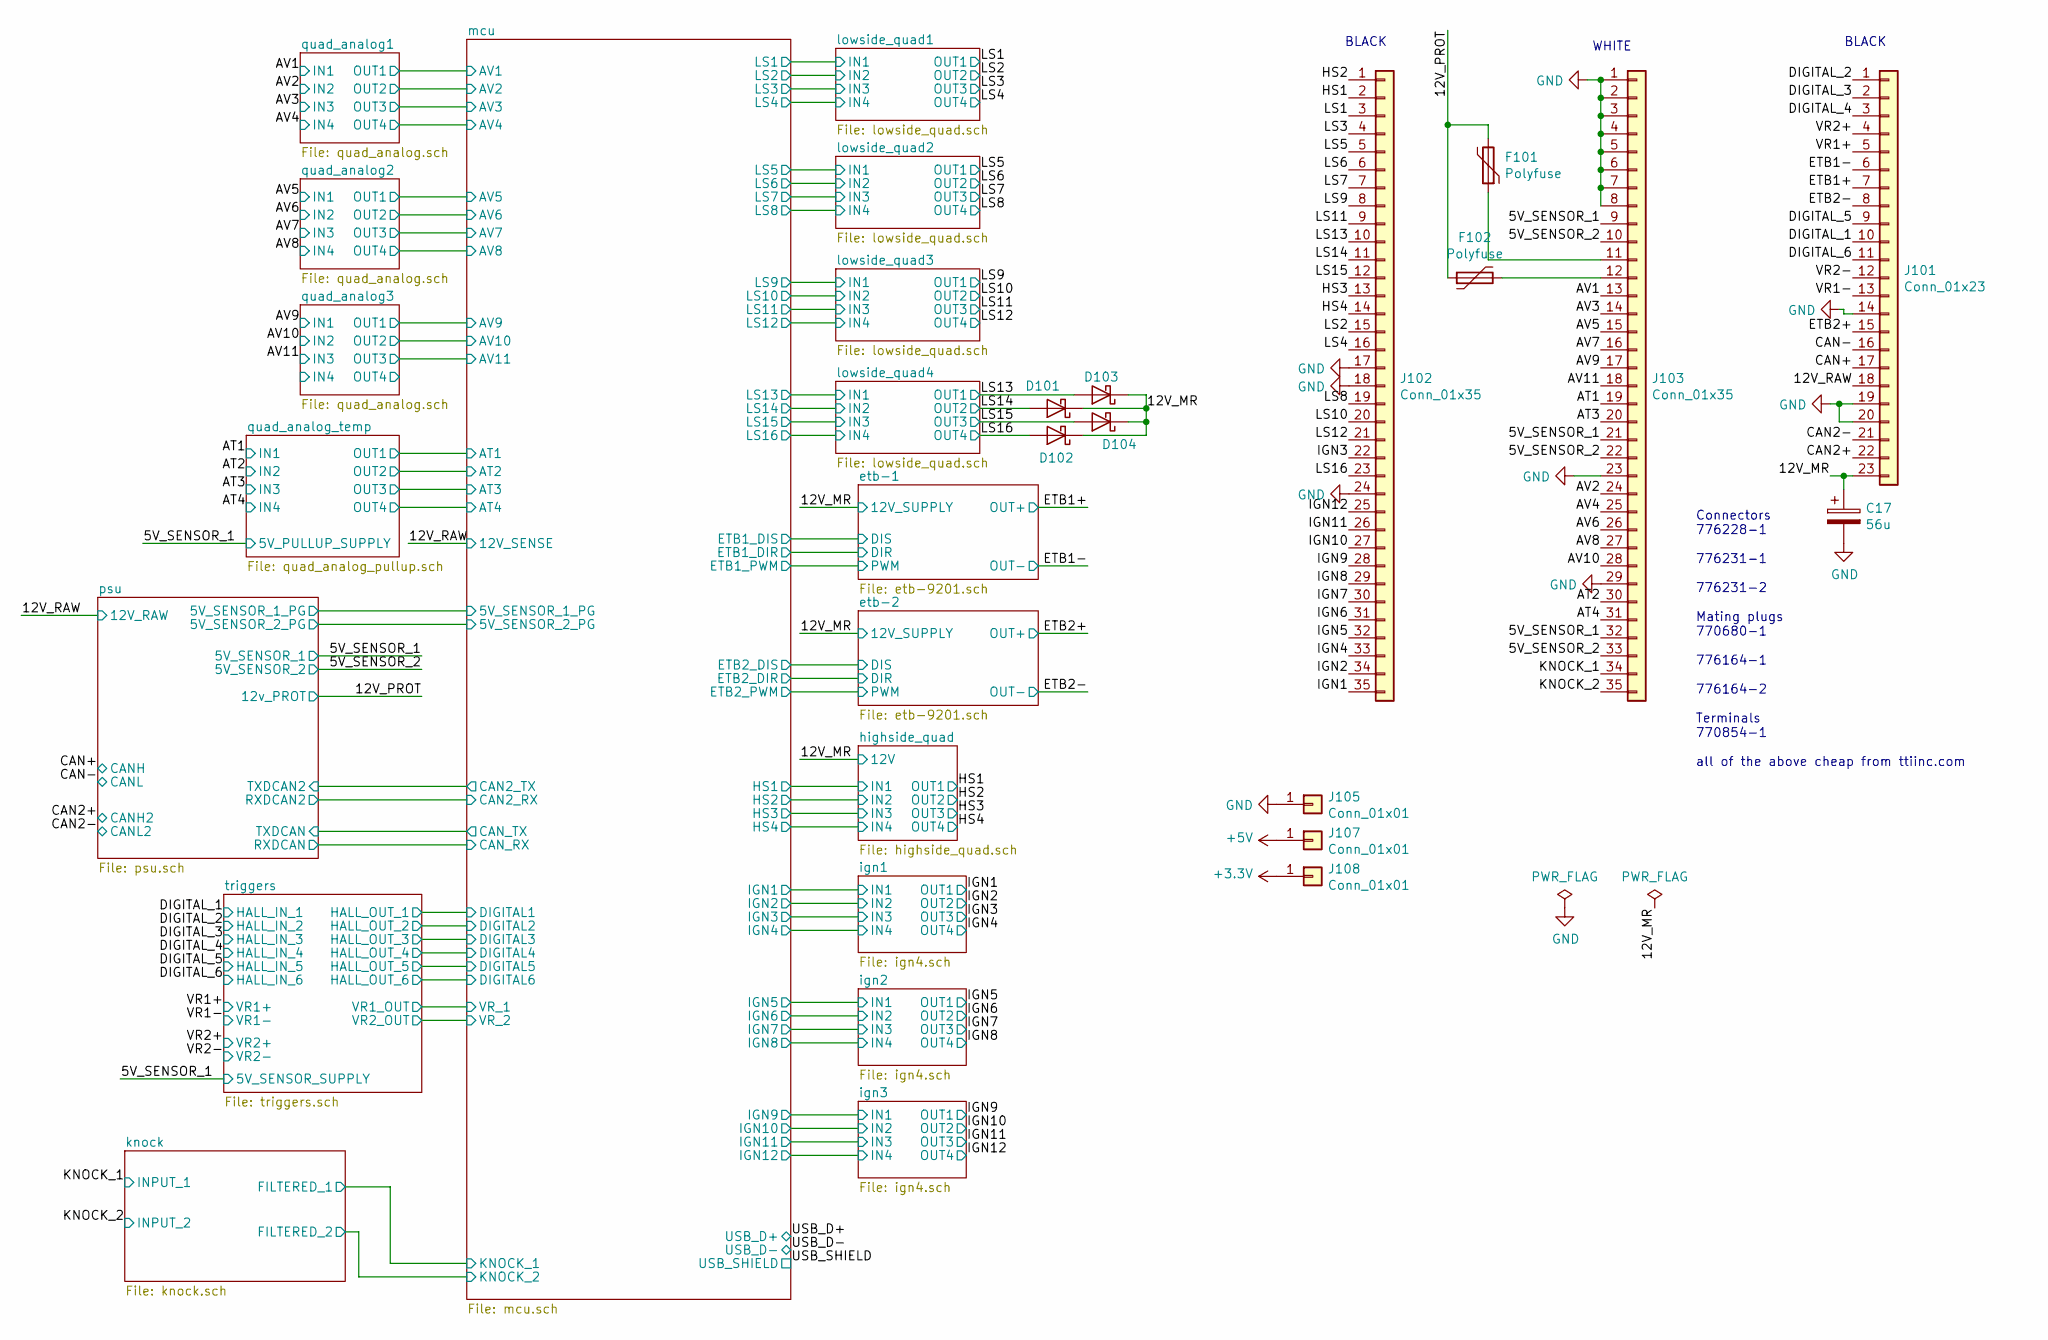
[picture p52: schematic proteus.sch]

Parts:
C17: 56u; CP_Radial_D8.0mm_P3.50mm; LCSC N/A
D101, D102, D103, D104: D_Schottky; D_SMA; LCSC C8678
F101, F102: Polyfuse; R_1206_3216Metric; LCSC C207035
J101: Conn_01x23; ampseal-23; LCSC N/A
J102: Conn_01x35; ampseal-35; LCSC N/A
J103: Conn_01x35; ampseal-35-2; LCSC N/A
J105, J107, J108: Conn_01x01; TestPoint_Pad_D3.0mm; LCSC N/A

Connections:
5V_SENSOR_1: J103.9, J103.21, J103.32
5V_SENSOR_2: J103.10, J103.22, J103.33
12V_MR: C17.1, D101.1 (K), D102.1 (K), D103.1 (K), D104.1 (K), J101.23
12V_PROT: F101.2, F102.1
12V_RAW: J101.18
+3.3V: J108.1
+5V: J107.1
AT1: J103.19
AT2: J103.30
AT3: J103.20
AT4: J103.31
AV1: J103.13
AV2: J103.24
AV3: J103.14
AV4: J103.25
AV5: J103.15
AV6: J103.26
AV7: J103.16
AV8: J103.27
AV9: J103.17
AV10: J103.28
AV11: J103.18
CAN2+: J101.22
CAN2-: J101.21
CAN+: J101.17
CAN-: J101.16
DIGITAL_1: J101.10
DIGITAL_2: J101.1
DIGITAL_3: J101.2
DIGITAL_4: J101.3
DIGITAL_5: J101.9
DIGITAL_6: J101.11
ETB1+: J101.7
ETB1-: J101.6
ETB2+: J101.15
ETB2-: J101.8
GND: C17.2, J101.14, J101.19, J101.20, J102.17, J102.18, J102.24, J103.1, J103.2, J103.3, J103.4, J103.5, J103.6, J103.7, J103.8, J103.23, J103.29, J105.1
HS1: J102.2
HS2: J102.1
HS3: J102.13
HS4: J102.14
IGN1: J102.35
IGN2: J102.34
IGN3: J102.22
IGN4: J102.33
IGN5: J102.32
IGN6: J102.31
IGN7: J102.30
IGN8: J102.29
IGN9: J102.28
IGN10: J102.27
IGN11: J102.26
IGN12: J102.25
KNOCK_1: J103.34
KNOCK_2: J103.35
LS1: J102.3
LS2: J102.15
LS3: J102.4
LS4: J102.16
LS5: J102.5
LS6: J102.6
LS7: J102.7
LS8: J102.19
LS9: J102.8
LS10: J102.20
LS11: J102.9
LS12: J102.21
LS13: D103.2 (A), J102.10
LS14: D101.2 (A), J102.11
LS15: D104.2 (A), J102.12
LS16: D102.2 (A), J102.23
unnamed: F101.1, J103.11
unnamed: F102.2, J103.12
VR1+: J101.5
VR1-: J101.13
VR2+: J101.4
VR2-: J101.12

Notes on the sheet:
Connectors 776228-1 776231-1 776231-2 Mating plugs 770680-1 776164-1 776164-2 Terminals 770854-1 all of the above cheap from ttiinc.com
BLACK
WHITE
