gerefi/proteus/quad_analog.sch

## KiCad design quad_analog.sch (2024-03-12)

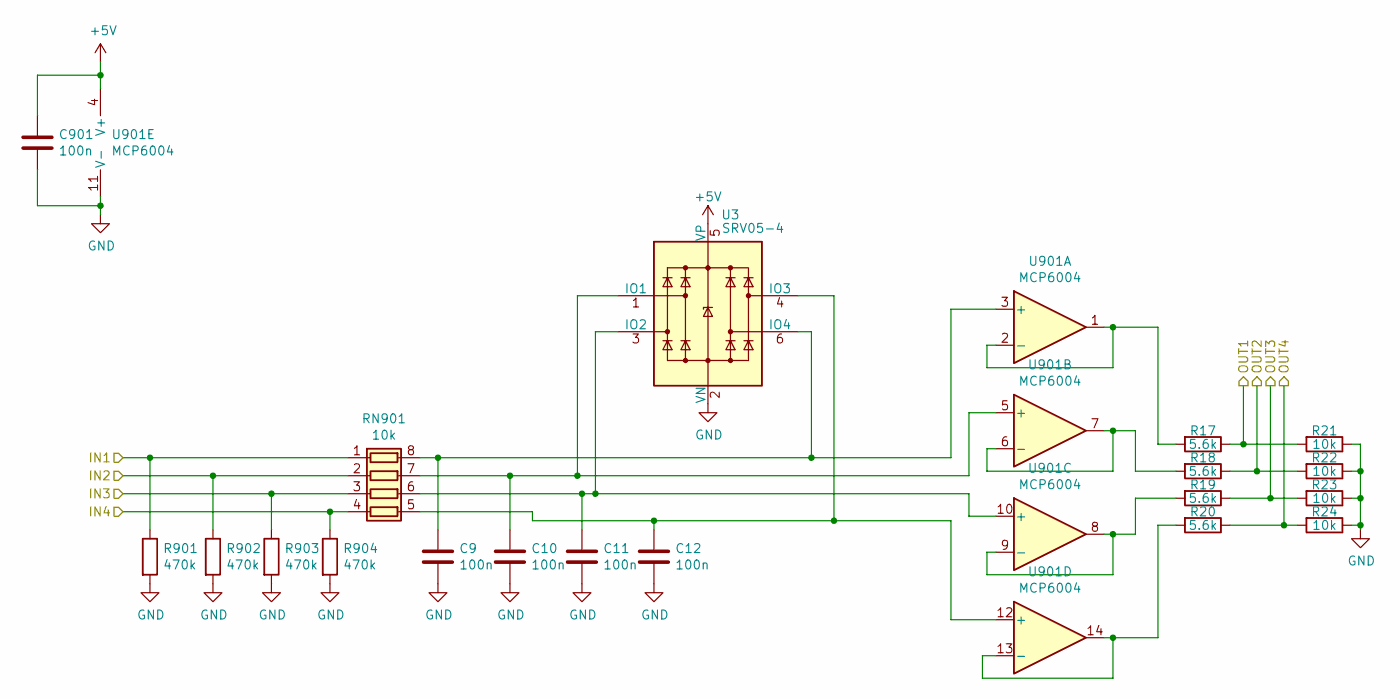
[picture p54: schematic quad_analog.sch]

Parts:
C1, C2, C3, C4: 100n; C_0402_1005Metric; LCSC C1525
C701: 100n; C_0603_1608Metric; LCSC C14663
R1, R2, R3, R4: 5.6k; R_0402_1005Metric; LCSC C25908
R5, R6, R7, R8: 10k; R_0402_1005Metric; LCSC C25744
R701, R702, R703, R704: 470k; R_0402_1005Metric; LCSC C25790
RN701: 10k; R_Array_Convex_4x0603; LCSC C29718
U1: SRV05-4; SOT-23-6; LCSC C85364
U701: MCP6004; TSSOP-14_4.4x5mm_P0.65mm; LCSC C50282

Connections:
+5V: C701.1, U1.5 (VP), U701.4 (V+)
GND: C1.2, C2.2, C3.2, C4.2, C701.2, R5.1, R6.1, R7.1, R8.1, R701.2, R702.2, R703.2, R704.2, U1.2 (VN), U701.11 (V-)
IN1: R701.1, RN701.1 (R1.1)
IN2: R702.1, RN701.2 (R2.1)
IN3: R703.1, RN701.3 (R3.1)
IN4: R704.1, RN701.4 (R4.1)
unnamed: C1.1, RN701.8 (R1.2), U1.6 (IO4), U701.3 (+)
unnamed: C2.1, RN701.7 (R2.2), U1.1 (IO1), U701.5 (+)
unnamed: C3.1, RN701.6 (R3.2), U1.3 (IO2), U701.10 (+)
unnamed: C4.1, RN701.5 (R4.2), U1.4 (IO3), U701.12 (+)
unnamed: R1.2, U701.1, U701.2 (-)
unnamed: R2.2, U701.6 (-), U701.7
unnamed: R3.2, U701.8, U701.9 (-)
unnamed: R4.2, U701.13 (-), U701.14
OUT1: R1.1, R5.2
OUT2: R2.1, R6.2
OUT3: R3.1, R7.2
OUT4: R4.1, R8.2
