gerefi/proteus/quad_analog_pullup.sch

## KiCad design quad_analog_pullup.sch (2024-03-12)

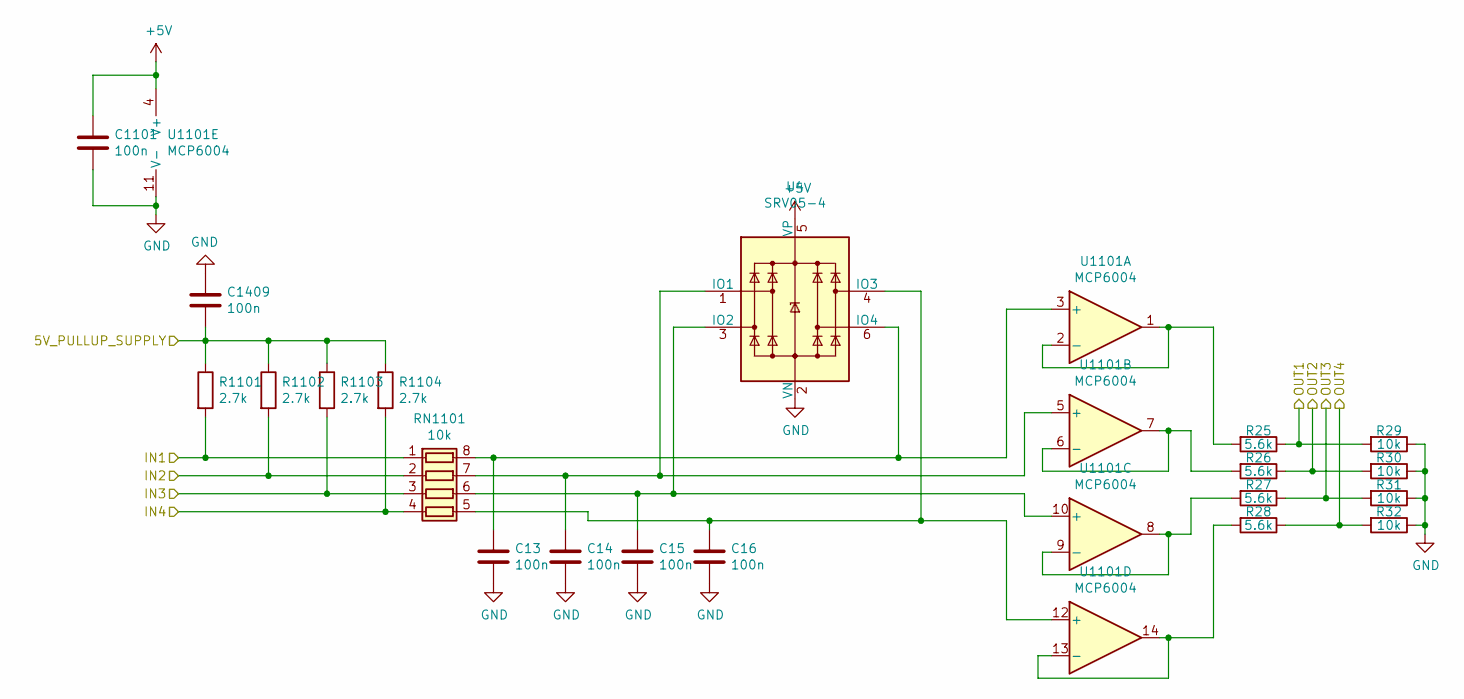
[picture p55: schematic quad_analog_pullup.sch]

Parts:
C13, C14, C15, C16: 100n; C_0402_1005Metric; LCSC C1525
C1101, C1409: 100n; C_0603_1608Metric; LCSC C14663
R25, R26, R27, R28: 5.6k; R_0402_1005Metric; LCSC C25908
R29, R30, R31, R32: 10k; R_0402_1005Metric; LCSC C25744
R1101, R1102, R1103, R1104: 2.7k; R_0603_1608Metric; LCSC C13167
RN1101: 10k; R_Array_Convex_4x0603; LCSC C29718
U4: SRV05-4; SOT-23-6; LCSC C85364
U1101: MCP6004; TSSOP-14_4.4x5mm_P0.65mm; LCSC C50282

Connections:
5V_PULLUP_SUPPLY: C1409.2, R1101.1, R1102.1, R1103.1, R1104.1
+5V: C1101.1, U4.5 (VP), U1101.4 (V+)
GND: C13.2, C14.2, C15.2, C16.2, C1101.2, C1409.1, R29.1, R30.1, R31.1, R32.1, U4.2 (VN), U1101.11 (V-)
IN1: R1101.2, RN1101.1 (R1.1)
IN2: R1102.2, RN1101.2 (R2.1)
IN3: R1103.2, RN1101.3 (R3.1)
IN4: R1104.2, RN1101.4 (R4.1)
unnamed: C13.1, RN1101.8 (R1.2), U4.6 (IO4), U1101.3 (+)
unnamed: C14.1, RN1101.7 (R2.2), U4.1 (IO1), U1101.5 (+)
unnamed: C15.1, RN1101.6 (R3.2), U4.3 (IO2), U1101.10 (+)
unnamed: C16.1, RN1101.5 (R4.2), U4.4 (IO3), U1101.12 (+)
unnamed: R25.2, U1101.1, U1101.2 (-)
unnamed: R26.2, U1101.6 (-), U1101.7
unnamed: R27.2, U1101.8, U1101.9 (-)
unnamed: R28.2, U1101.13 (-), U1101.14
OUT1: R25.1, R29.2
OUT2: R26.1, R30.2
OUT3: R27.1, R31.2
OUT4: R28.1, R32.2
