gerefi/proteus/triggers.sch

## KiCad design triggers.sch (2024-03-12)

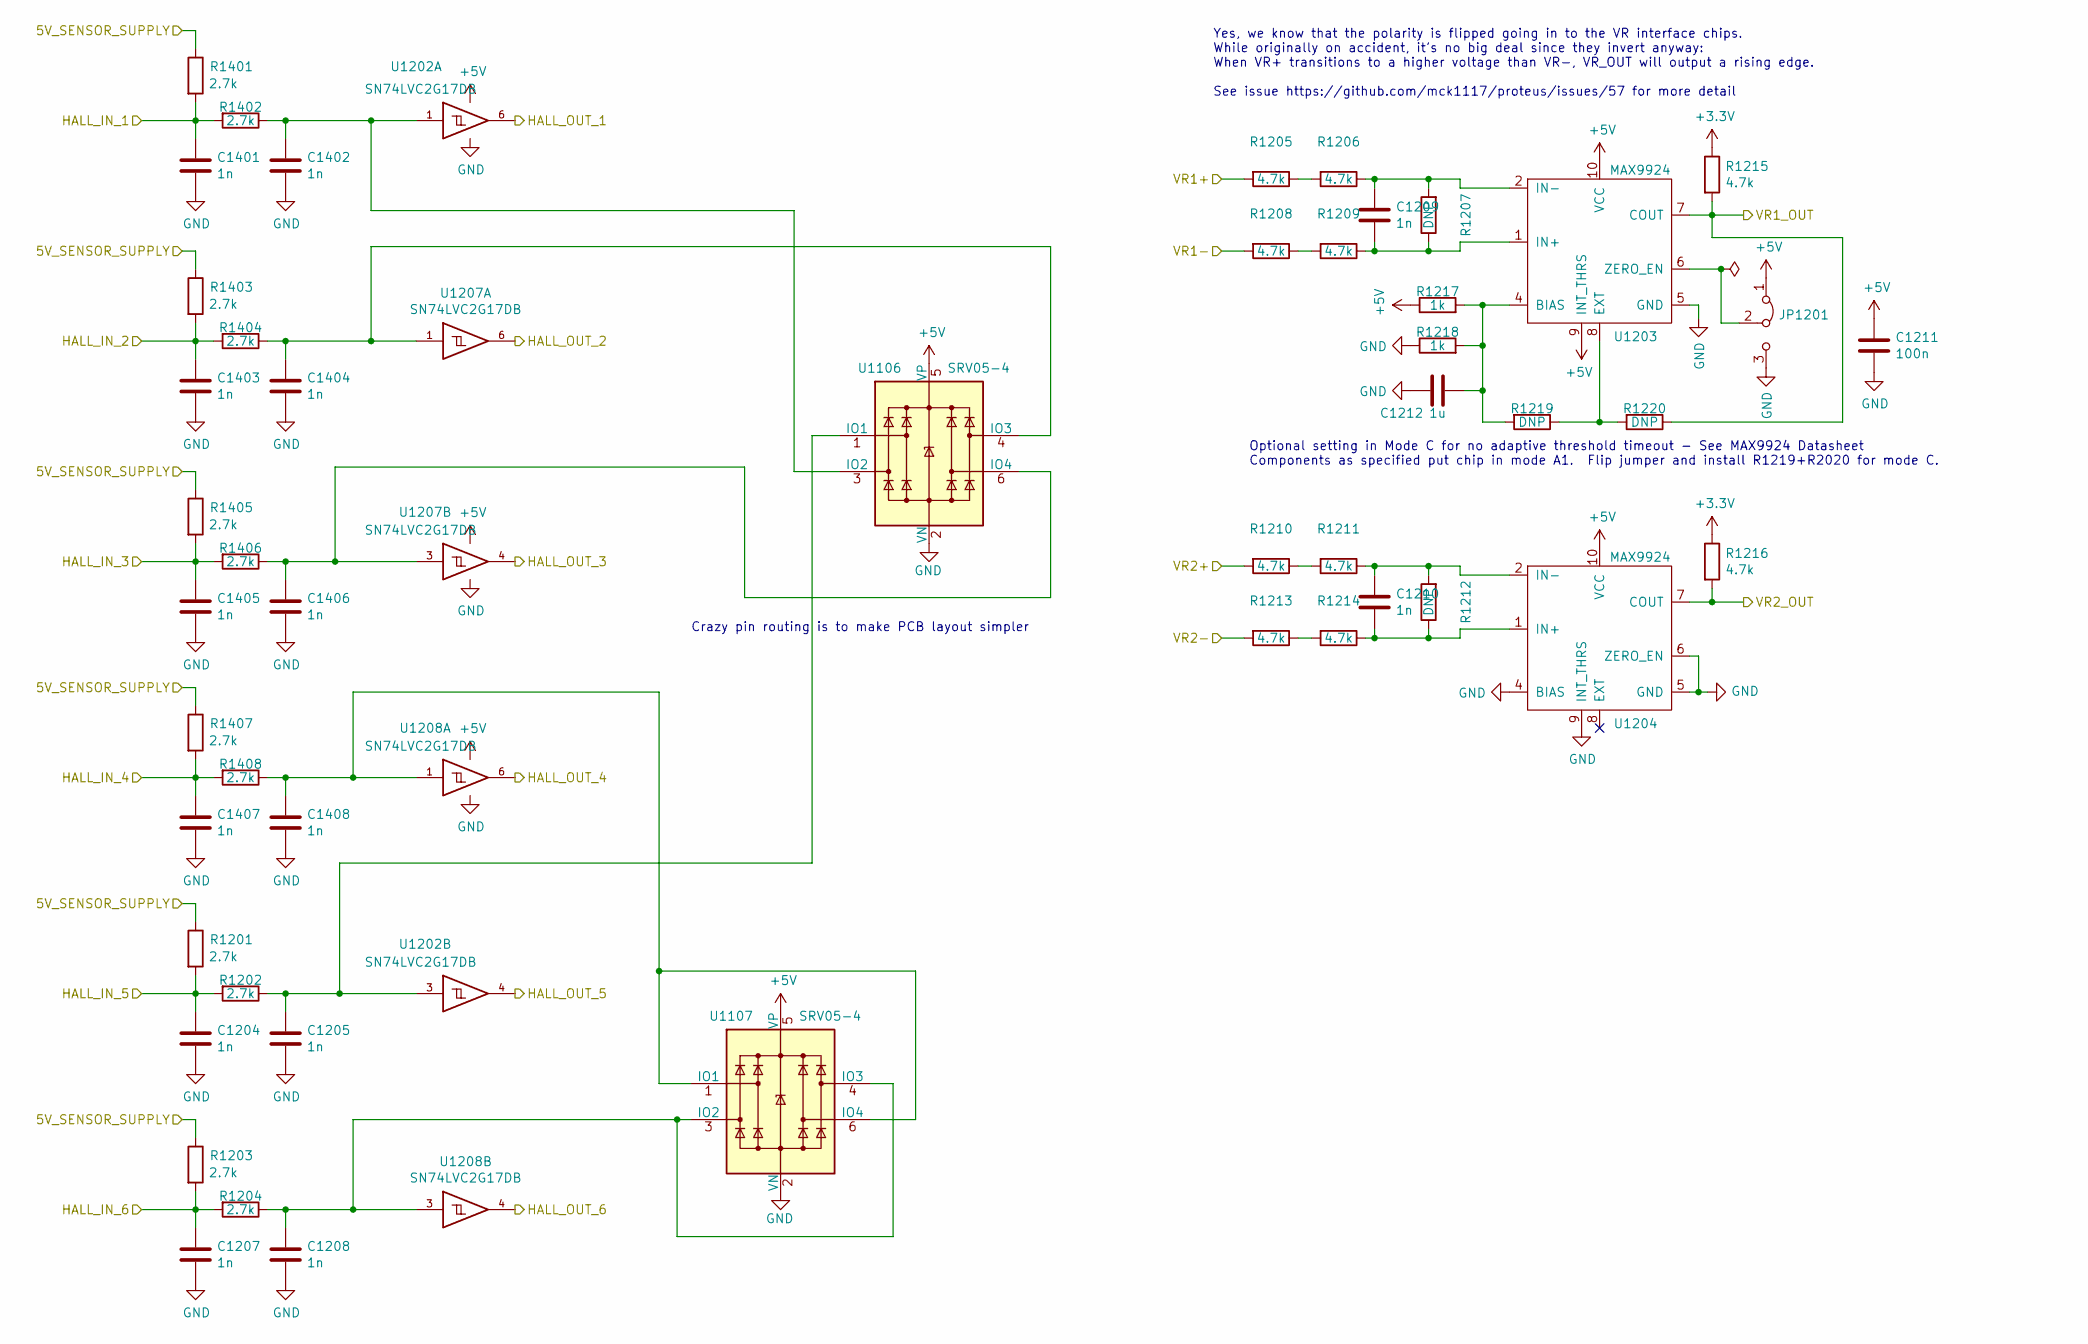
[picture p56: schematic triggers.sch]

Parts:
C1204, C1205, C1207, C1208, C1209, C1210, C1401, C1402, C1403, C1404, C1405, C1406, C1407, C1408: 1n; C_0603_1608Metric; LCSC C1588
C1211: 100n; C_0603_1608Metric; LCSC C14663
C1212: 1u; C_0603_1608Metric; LCSC C15849
JP1201: Jumper_3_Bridged12; SolderJumper-3_P1.3mm_Bridged12_RoundedPad1.0x1.5mm; LCSC N/A
R1201, R1202, R1203, R1204, R1401, R1402, R1403, R1404, R1405, R1406, R1407, R1408: 2.7k; R_0603_1608Metric; LCSC C13167
R1205, R1206, R1208, R1209, R1210, R1211, R1213, R1214, R1215, R1216: 4.7k; R_0805_2012Metric; LCSC C17673
R1207, R1212: DNP; R_0805_2012Metric; LCSC DNP
R1217, R1218: 1k; R_0402_1005Metric; LCSC C11702
R1219, R1220: DNP; R_0805_2012Metric_Pad1.15x1.40mm_HandSolder; LCSC DNP
U1106, U1107: SRV05-4; SOT-23-6
U1202, U1207, U1208: SN74LVC2G17DB; SOT-23-6; LCSC C10429
U1203, U1204: MAX9924; MSOP-10_3x3mm_P0.5mm; LCSC N/A

Connections:
5V_SENSOR_SUPPLY: R1201.1, R1203.1, R1401.1, R1403.1, R1405.1, R1407.1
+3.3V: R1215.1, R1216.1
+5V: C1211.1, JP1201.1 (A), R1217.1, U1106.5 (VP), U1107.5 (VP), U1202.5 (VCC), U1203.9 (INT_THRS), U1203.10 (VCC), U1204.10 (VCC), U1207.5 (VCC), U1208.5 (VCC)
GND: C1204.2, C1205.2, C1207.2, C1208.2, C1211.2, C1212.2, C1401.2, C1402.2, C1403.2, C1404.2, C1405.2, C1406.2, C1407.2, C1408.2, JP1201.3 (B), R1218.1, U1106.2 (VN), U1107.2 (VN), U1202.2 (GND), U1203.5 (GND), U1204.4 (BIAS), U1204.5 (GND), U1204.6 (ZERO_EN), U1204.9 (INT_THRS), U1207.2 (GND), U1208.2 (GND)
HALL_IN_1: C1401.1, R1401.2, R1402.2
HALL_IN_2: C1403.1, R1403.2, R1404.2
HALL_IN_3: C1405.1, R1405.2, R1406.2
HALL_IN_4: C1407.1, R1407.2, R1408.2
HALL_IN_5: C1204.1, R1201.2, R1202.2
HALL_IN_6: C1207.1, R1203.2, R1204.2
HALL_OUT_1: U1202.6
HALL_OUT_2: U1207.6
HALL_OUT_3: U1207.4
HALL_OUT_4: U1208.6
HALL_OUT_5: U1202.4
HALL_OUT_6: U1208.4
unnamed: C1205.1, R1202.1, U1106.1 (IO1), U1202.3
unnamed: C1208.1, R1204.1, U1107.3 (IO2), U1107.4 (IO3), U1208.3
unnamed: C1209.1, R1206.1, R1207.2, U1203.2 (IN-)
unnamed: C1209.2, R1207.1, R1209.1, U1203.1 (IN+)
unnamed: C1210.1, R1211.1, R1212.2, U1204.2 (IN-)
unnamed: C1210.2, R1212.1, R1214.1, U1204.1 (IN+)
unnamed: C1212.1, R1217.2, R1218.2, R1219.2, U1203.4 (BIAS)
unnamed: C1402.1, R1402.1, U1106.3 (IO2), U1202.1
unnamed: C1404.1, R1404.1, U1106.4 (IO3), U1207.1
unnamed: C1406.1, R1406.1, U1106.6 (IO4), U1207.3
unnamed: C1408.1, R1408.1, U1107.1 (IO1), U1107.6 (IO4), U1208.1
unnamed: JP1201.2 (C), U1203.6 (ZERO_EN)
unnamed: R1205.1, R1206.2
unnamed: R1208.1, R1209.2
unnamed: R1210.1, R1211.2
unnamed: R1213.1, R1214.2
unnamed: R1219.1, R1220.2, U1203.8 (EXT)
VR1+: R1205.2
VR1-: R1208.2
VR1_OUT: R1215.2, R1220.1, U1203.7 (COUT)
VR2+: R1210.2
VR2-: R1213.2
VR2_OUT: R1216.2, U1204.7 (COUT)

Notes on the sheet:
Optional setting in Mode C for no adaptive threshold timeout - See MAX9924 Datasheet Components as specified put chip in mode A1. Flip jumper and install R1219+R2020 for mode C.
Yes, we know that the polarity is flipped going in to the VR interface chips. While originally on accident, it’s no big deal since they invert anyway: When VR+ transitions to a higher voltage than VR-, VR_OUT will output a rising edge. See issue https://github.com/mck1117/proteus/issues/57 for more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
Crazy pin routing is to make PCB layout simpler
